TAHA-brazy/electro-hydraulic-control-system/report_ar.pdf

# التعرف التجرييب والتحكم مبخدم كهروهيدروليكي

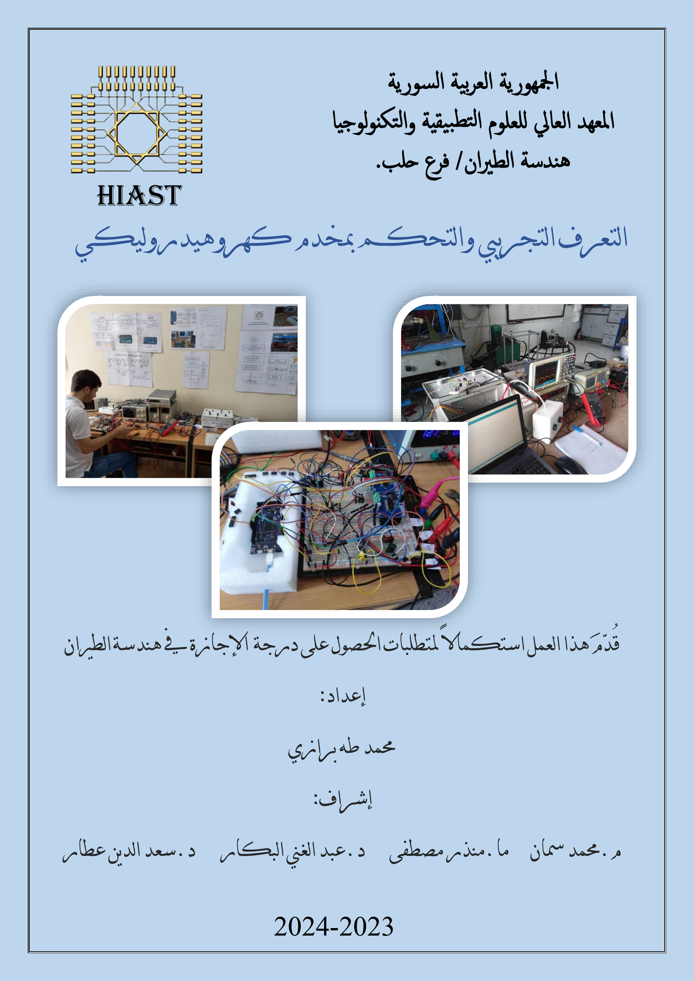
[picture p17: page 1]

### HIAST

امجلهورية العربية السوري ة املعهد العايل للعلوم التطبيقية والتكنولوجي ا هندسة الطريان / فرع حلب .

## قُدّمَ هذا العملاستكماالً ملتطلباتاحلصول على درجة اإلجازة يف هندسة الطريان إعداد: حممد طه برازي إشراف: م.حممد مسان ما.منذر مصطفى د.عبد الغين البكار د.سعد الدين عطار

2024-2023

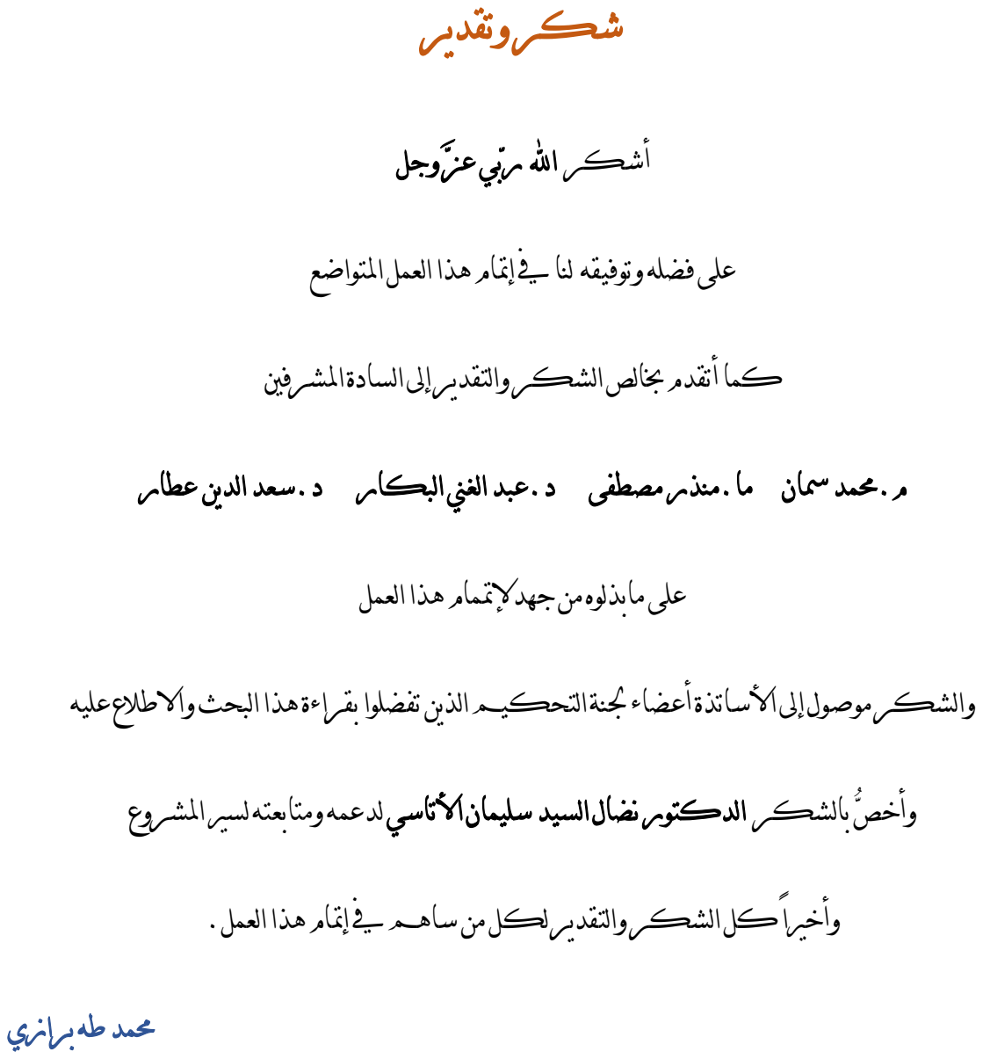
[picture p18: figure]
شكر وتقدير; أشكر اهلل ربّ ي عز وجل; على مابذلوه من جهدإلمتمام هذا العمل; حممد طه برازي

i

على فضله وتوفيقه لنا يف إمتام هذا العمل املتواضع

كما أتقدم خبالص الشكر والتقدير إىل السادة املشرفني

م.حممد مسان ما.منذر مصطفى د.عبد الغين البكار د.سعد الدين عطار

والشكر موصول إىل األساتذة أعضاء جلنة التحكيم الذين تفضلوا بقراءة هذا البحث واالطالع عليه

وأخصُّ بالشكر الدكتور نضال السيد سليمان األتاسيلدعمه ومتابعته لسري املشروع

وأخرياً كل الشكر والتقدير لكل من ساهم يف إمتام هذا العمل.

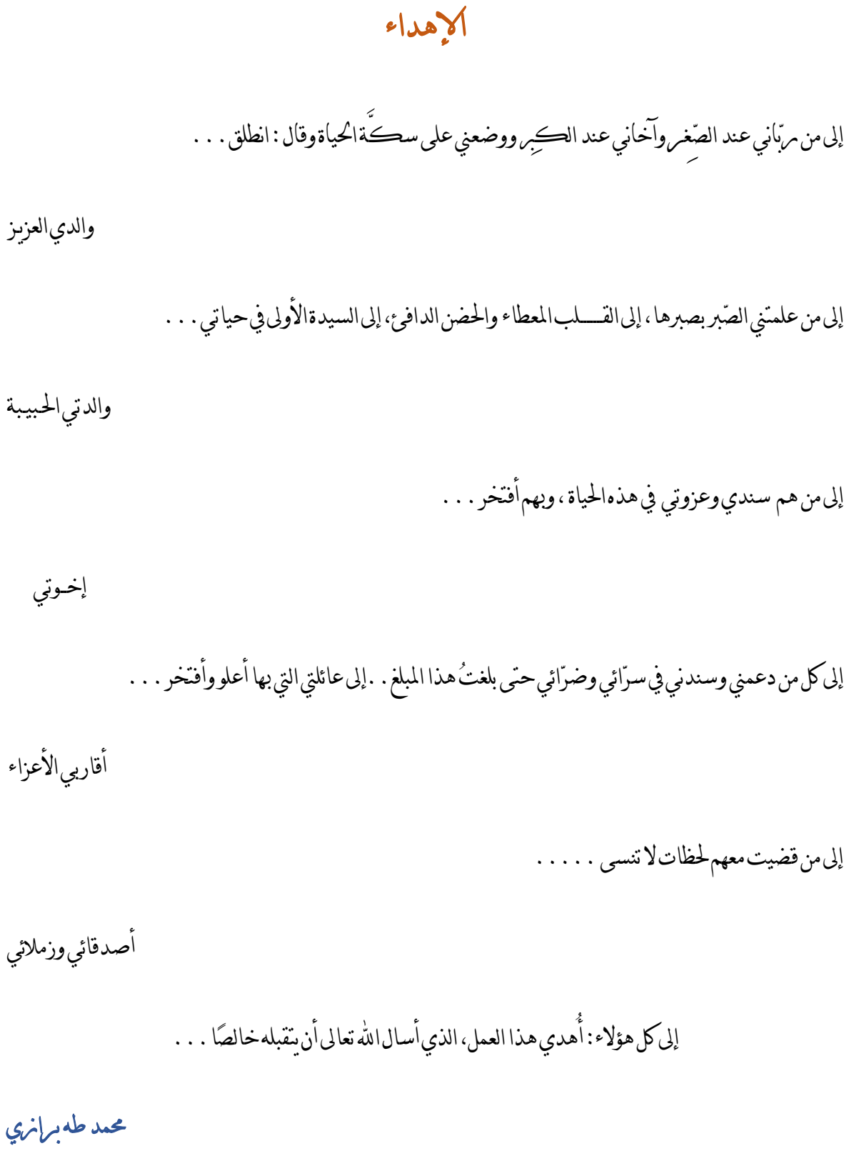
[picture p19: figure]
اإلهداء; والدي العزيـز; والدتي احلـبيـبة; إخــوتي; أقاربي األعزاء; إىل من قضيت معهم حلظات ال تنسى .....; أصدقائي وزمالئي; حممد طه برازي

ii

إىل منربّانيعند الصِّغر وآخاني عند الكِرب ووضعين على سكَّة احلياة وقال : انطلق.. .

إىل من علمتين الصّرب بصربها، إىل القـــــــلب املعطاءواحلضن الدافئ، إىل السيدة األوىل يف حياتي...

إىل من هم سندي وعزوتي يف هذه احلياة ، وهبم أفتخر...

إىل كل من دعمين وسندني يف سرّائي وضرّائي حتى بلغتُ هذا املبلغ..إىل عائليت اليت هبا أعلو وأفتخر...

إىل كل هؤالء: أُهدي هذا العمل، الذي أسال اهلل تعاىل أن يتقبله خالصًا...

iii

ملخص المشروع

يهدف هذا المشروع إلى تطوير دارة قيادة موثوقة تلبي متطلبات التشغيل والتحكم بالمنظومة الكهروهيدروليكية، وتطبيق إجرائية التعرف على النظام بهدف تحصيل نماذج معامالتية خطية والخطية ُستخدم في تصميم

ت مصحح للتحكم بالموضع مع تغذية أمامية للتغلب على العناصر الالخطية، واستخدام
ًة | تقنية التحكم التتابعي للتحكم بالتسارع كحلقة رئيسية إلى حلقة

إضاف الموضع الثانوية.

iv

Abstract

This project aims to develop a reliable driver circuit that meets the operational and control requirements of the electro-hydraulic system. It also aims to apply system identification procedures to obtain linear and nonlinear parametric models used in designing a position control corrector with feedforward to overcome nonlinear elements. Furthermore, the project uses cascade control techniques to control acceleration as the main loop, in addition to a secondary position loop.

v

فهرس المحتويات

2.1 مقدمة: 10 |
2.2 وحدة القيادة 7960BTS : 11 |
2.3 دارة المالئمة بين خرج مقسم الجهد )Potentiometer )ودخل المحول ADC : 14....
2.4 دارة مرشح تمرير منخفض تشابهي Circuit Filter Pass Low: 15 |
2.5 دارة تنظيم الجهد Circuit Voltage Regulator: 18 |
2.6 بطاقة المتحكم الصغري Due Arduino20 | :
2.7 المحول التشابهي الرقمي D/A: 21 |
2.8 مولد إشارة الـPWM: 22 |
2.9 برنامج المتحكم الصغري: 22 |
2.10 المرشح الرقمي: 23 |
الفصل الثالث: التعرف التجريبي 27 |
3.1 مقدمة 28 |
3.2 التعرف في الحلقة المغلقة: 30 |
3.3 إشارات التحفيز المستخدمة في التعرف31 | :

vi

3.4 اإلشارة الثنائية العشوائية المزيفة PRBS : 32 |
3.5 تصميم تجربة التعرف: 33 |
3.6 إجرائية تنفيذ التعرف التجريبي: 35 |
3.7 برنامج المتحكم الصغري في تجربة التعرف36 | :
3.8 تحليل النتائج ومناقشتها: 38 |
3.9 تجربة التعرف على نموذج التحكم Model Process: 39 |
3.10 تجارب التعرف على نماذج التنبؤ والنمذجة والمحاكاة: 41 |
الفصل الرابع: التحكم بالمخدم 48 |
4.1 مقدمة: 49 |
4.2 نمذجة النظام المدروس باستخدام برنامج المحاكاة Simulink\MATLAB: 49.......
50 | :Non-Linear Items | الالخطية | العناصر | 4.3
4.3.1 المنطقة الميتة (zone Dead(: 51 |
4.3.2 التأخير الزمني ) delay Time)54 | :
4.3.3 حد اإلشباع (Saturation)56 | :
4.4 التحكم بالموضع: 57 |
4.4.1 تحديد بارامترات المصحح: 57 |
ّ | 4.4.2 م الطور:

ة لمصحح مقد
ّ
المعادلة الفرقي 60 |
4.4.3 تجارب الدارة المغلقة مع مصحح مقدم الطور بعد عملية tuning: 61...
4.5 التحكم التتابعي Control Cascade: 63 |
4.5.1 التحكم التتابعي باستخدام حلقة التسارع وحلقة الموضع: 64 |
الخاتمة والتوصيات المستقبلية70 | :
المراجع العلمية 71 |

vii

فهرس األشكال

شكل -10المخطط العام لدارة القيادة 10 |
شكل -11دارة مرشح منخفض للتيار 12 |
شكل -12العالقة بين الجهد Vis وتيار الحمولة I 12 |
شكل -13تحويل االشارة النبضية إلى اشارة مستمرة 13 |
شكل -14دارة مالئمة جهد خرج ال potentiometer مع دخل المحول D/A15 |
شكل -15مرشح تمرر منخفض تشكيلة Kay Sallen من المرتبة األولى 16 |
شكل -16مرشح تمرر منخفض تشكيلة Kay Sallen من المرتبة الثانية 16 |
شكل -17مرشح تمرير منخفض نوع Butterworth تشكيلة kay sallen من المرتبة الثالثة 18 |
شكل -18مخطط بود لمرشح التمرير المنخفض من المرتبة الثالثة 18 |
شكل -20المرشح الوسطي 24 |
شكل -21 المخطط العام لدارة القيادة 24 |
شكل -22دارة القيادة أثناء االختبار 25 |
شكل -23مراحل تنفيذ عملية التعرف 29 |
شكل -24البنية األساسية لنظام في الحلقة المغلقة 30 |
شكل -25آلية إرسال واستقبال األوامر من وإلى المتحكم في تجربة التعرف 34 |
شكل -26مراحل تنفيذ التعرف التجريبي 35 |
شكل -27خوارزمية عمل المتحكم في تجربة التعرف37 |

viii

شكل -28الواجهة التخاطبية لصندوق أدوات تعريف النظام في ماتالب39 |
شكل -29بيانات دخل وخرج النظام المحصلة من أجل إشارة تحفيز نبضية 40 |
شكل -30مخطط البواقي40 |
شكل -31نسبة الباس نموذج Model Process المقدر لبيانات التحقق 41 |
شكل -32بيانات دخل وخرج النظام المحصلة من أجل إشارة تحفيز PRBS42 |
شكل -33بنية نموذج Wiener-Hammerstein الالخطي 43 |

شكل -34نسبة االلباس لنماذج Wiener-Hammerstein و Function Transfer ,Tclck =
43 | 28ms
شكل -35 نسبة االلباس لنماذج Wiener-Hammerstein و Function Transfer ,Tclck =
45 | 28ms
شكل -36تحليل البواقي لنماذج Wiener-Hammerstein و Function Transfer46 |
شكل -37 مكونات الجزء الخطي من نموذج Wiener-Hammerstein46 |
شكل -38نمذجة نموذج Wiener-Hammerstein في Simulink 47 |
شكل -39حلقة التحكم بنظام المخدم الكهروهيدروليكي 49 |
شكل -40نمذجة النظام باستخدام برامجSimulink\MATLAB 50 |
شكل -41 محاكاة استجابة النظام من أجل دخل قفزة 50 |
شكل -42تعريف المنطقة الميتة 51 |
شكل -43نمذجة المنطقة الميتة 51 |
شكل -44محاكاة استجابة النظام بوجود المنطقة الميتة 52 |
شكل -45 نمذجة حل الخطية المنطقة الميتة 52 |
شكل -46 استجابة النظام بعد إدخال حل الخطية المنطقة الميتة 53 |
شكل -47استجابة النظام الحقيقية بعد زرع حل الخطية المنطقة الميتة 53 |
شكل -48تعريف التأخير الزمني delay Time54 |
شكل -49 التأخيرالزمني من أجل دخل lov4 . = ets55 |
شكل -50نمذجة التأخير الزمني 56 |
شكل -51استجابة النظام بعد نمذجة التأخير الزمني 56 |
شكل -52المتطلبات التصميمية لنظام التحكم بالمخدم الكهروهيدروليكي 57 |
شكل -53مخطط بود للنظام قبل وبعد إضافة مصحح مقدم الطور 59 |
شكل -54مخطط مسار الجذور للنظام قبل وبعد إضاقة مصحح مقدم الطور 59 |
شكل -55االستجابة الزمنية للنظام قبل وبعد إضافة مصحح مقدم الطور 60 |

ix

شكل -56استجابة النظام الحقيقية قبل وبعد إضافة مصحح مقدم الطور 62 |
شكل -57التحكم التتابعي control Cascade63 |
شكل -58استجابة النظام في أداة engiseDmetsySlortnoc64 |
شكل -59المتطلبات التصممية للنظام في حلقتي التحكم في التسارع والموضع 65 |
شكل -60اختيار بنية حلقتي تحكم في أداة engiseDmetsySlortnoc65 |
شكل -61استجابة النظام بعد إضافة حلقتي تحكم 67 |
شكل -62معامالت مصحح حلقة التسارع 68 |
شكل -63معامالت مصحح حلقة الموضع 68 |

x

فهرس الصور

صورة 7960-5BTS11 |
صورة -6آلية التحكم جسر H14 |
صورة -7 بطاقة DUE Arduino 20 |
صورة -8الواجهة التخاطبية للقيادة والتحكم بالمخدم نمط loop Open25 |
صورة9 - الواجهة التخاطبية للقيادة والتحكم بالمخدم نمط loop Closed26 |
صورة -10صورة عن بيئة العمل وعرض بيانات الدخل والخرج أثناء التحصيل 38 |

xi

فهرس الجداول

جدول -1قيم الثوابت حسب مرشحات Butterworth17 |

جدول -2نسب التطابق لنماذج Wiener-Hammerstein وFunction Transfer من أجل 10=N و
clcT متغيرة 44 |

جدول -3 نسب التطابق لنماذج Wiener-Hammerstein وFunction Transfer من أجل 12=N و
clcT متغيرة 45 |
جدول -4قيم التأخير الزمني من جهد دخل محدد 55 |
جدول -5مقارنة بين خصائص النظام قبل وبعد إضافة مصحح مقدم الطور 62 |

املعـــهد الع ــــايل للع ـــلوم التطبيقية والتكنولوجيــــا – الســـنة اخلامسة – حمـــمد طــه بــرازي

1

مقدمة عن المشروع:

ً

أساسيا من التكنولوجيا الحديثة المستخدمة في مجموعة واسعة | ً | تعتبر األنظمة الهيدروليكية جزء
من التطبيقات. تعتمد هذه األنظمة على استخدام السوائل المضغوطة لنقل الطاقة وتحقيق الحركات الميكانيكية بدقة وكفاءة عالية. يتطلب تشغيل األنظمة الهيدروليكية بشكل صحيح وجود تحكم دقيق في الضغط والتدفق، مما يستدعي تصميم حلقات تحكم قادرة على تلبية هذه المتطلبات بكفاءة ووثوقية.
يهدف هذا المشروع إلى تصميم دارة قيادة الكترونية لمنظومة كهرو هيدروليكية، تتضمن التحكم
في صمام تخفيض الضغط وصمام التوجيه الهيدروليكي لقيادة مخدم كهروهيدروليكي متصل مع طاولة رجاجة تهتز وفق محور وحيد . باإلضافة إلى ذلك، سيتناول المشروع إجرائية التعرف على المنظومة، وذلك من أجل تطبيق تقنيات التحكم لتصميم متحكم قادر على تحسين أداء النظام. تتكون م ارحل المشروع من عدة خطوات رئيسية تشمل: د ارسة المكونات األساسية للنظام الهيدروليكي، تصميم وتنفيذ دارة القيادة، تحصيل البيانات العملية من النظام، تحليل البيانات للتعرف على النظام ا تصميم وتنفيذ واختبار متحكم مناسب ً

، وأخير .
سيسهم هذا المشروع في تقديم فهم أعمق لتطبيقات األنظمة الهيدروليكية والتحكم فيها، مع التركيز على تطوير حلول تساهم في تحسين األداء وضمان االستقرار والوثوقية. تعتبر النتائج المتوقعة من هذا المشروع خطوة مهمة نحو تعزيز المعرفة في مجال األنظمة الهيدروليكية والتحكم بها، وتقديم حلول عملية يمكن تطبيقها في الصناعة. تتكون األطروحة من أربعة فصول على الشكل التالي: .1 التعريف بالمنظومة الهيدروليكية. .2 تطوير وتنفيذ دارة القيادة. .3 التعرف التجريبي على المخدم. التحكم بالمخدم.

2

# الفصل األول: التعريف بالمنظومة الكهروهيدروليكية

3

### 1.1 مقدمة:

تعتبر المخدمات الهيدروليكية من األدوات الهامة في التطبيقات المدنية والعسكرية بسبب قدرتها العالية على توليد الطاقة و تمتعها بخصائص عديدة. انتشرت المخدمات الهيدروليكية بشكل واسع في مجموعات متنوعة من الصناعات بسبب صغر حجمها مقارنة مع الطاقة التي تقدمها، و أدائها األكثر سالسة عند السرعات المنخفضة، وقدرتها على تطبيق قوة وعزم دوران كبيرين للغاية و ال تزال هذه األنظمة مستخدمة بكثرة في التطبيقات عالية األداء مثل أنظمة التصنيع وآالت اختبار المواد ومحاكاة الطيران والسفن والروبوتات. في التطبيقات الهيدروليكية، يمكن قيادة المخدمات الكهروهيدروليكية عن طريق أوامر الكترونية تتحكم بالتدفق المطلوب، ومع ذلك فإن مشاكل النظام الهيدروليكي هي انعدام خطيتها وانخفاض التخميد ، و يصعب في بعض التطبيقات التحكم الدقيق في هذه األنظمة بسبب الالخطية، و لتحسين أداء المخدم الكهروهيدروليكي يلزم وجود متحكم مناسب .

### 1.2 المخطط الصندوقي للدارة الهيدروليكية:

شكل -1المخطط الصندوقي للدارة الكهروهيدروليكية

### 1.3 المكونات األساسية للدارة الهيدروليكية المستخدمة:

1.3.1 وحدة التغذية الهيدروليكية: تتضمن محرك كهربائي يقوم بتشغيل المضخة الهيدروليكية التي
تقوم بتحويل الطاقة الميكانيكية إلى طاقة هيدروليكية )قوة وضغط(، باإلضافة إلى صمام تنفيس الضغط الذي يقوم بتحديد الضغط األعظمي الخارج من المضخة على القيمة ab ،125 وصمام توجيه 3/4 يعمل بجهد v.24 كما تحتوي على فلتر الضغط العالي وفلتر خط العودة اللذان يقومان يتنقية السائل الهيروليكي )زيت( من الشوائب والمحافظة
وحدة التغذية الكهروهيدروليكية | وحدة التحكم الكهروهيدروليكية

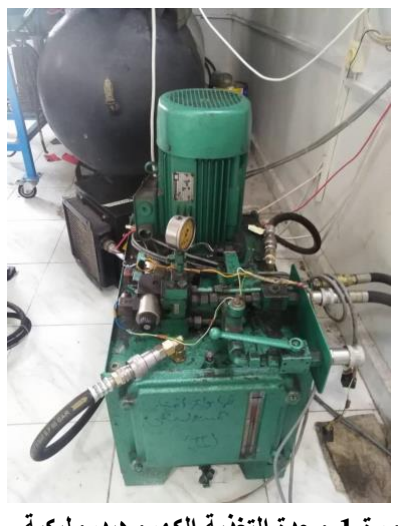
[picture p20: figure]

صورة -1وحدة التغذية الكهروهيدروليكية

4

على نظافته.
1.3.2 وحدة التحكم الكهروهيدروليكية : تتضمن وحدة التحكم الصمامين التاليين:

1.3.2.1صمام التوجيه 3/4 Valve Directional:
الغرض األساسي من هذا الصمام هو التحكم باتجاه الجريان باتجاهين متعاكسين إذ يملك ثالث وضعيات، وضعية إغالق ووضعيتين فتح تسمحان بمرور السائل باتجاهين متعاكسين، ويملك أربع مسارات : المضخة p والخزان T والمسارين A و B يتصالن بطرفي المخدم. ال يقبل الصمام تطبيق إشارة جهد متغيرة فإما أن يكون في حالة ON او في حالة OFF وفق اتجاه معين. يتكون بشكل اساسي من ملفين )وشيعتين( ملفوفين على طرفي الصمام، ومنزلقة ونابضين. حاالت عمل الصمام وفق الشكل )2(: .1 حالة عدم وجود تحريض على الملفات )الوضعية المتوسطة(: يكون الصمام في حالة إغالق)ال يوجد تدفق للسائل(.

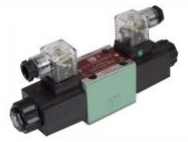
[picture p21: figure]
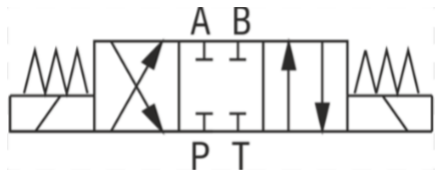
[picture p22: figure]

.2 حالة وجود تحريض على أحد الملفين: يمر تيار في الملف ً عن الملف مما يؤدي إلى

فيؤدي ذلك الى توليد قوة محركة كهربائية تدفع المنزلقة مبتعدة فتح الصمام وعبور السائل.
بتلك اآللية السابقة يتم التحكم بجهة الجريان. موديل الصمام المستخدم هو -50N24-D2-C-01-3DSG. كما توضح ال نشرة الفنية الخاصة بالصمام فإن التدفق األعظمي للصمام هو im/ 63 وضغط
2 | العمل األعظمي هو c/gK 315

، ويجب تغذيته بتغذية مستمرة ) DC )v24 ويكون تيار
الحمل األعظمي A.1.1

صورة -2صمام التوجيه

شكل -2وضعيات عمل صمام

التوجيه

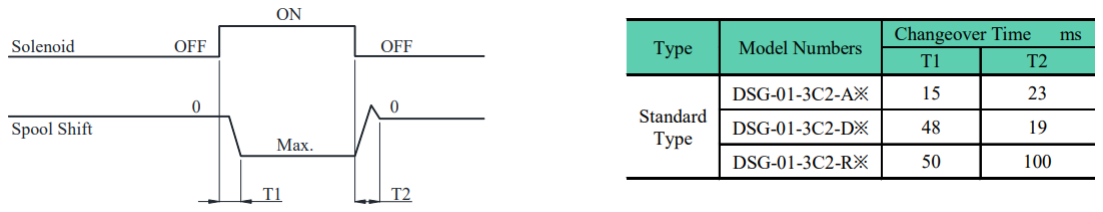
[picture p23: figure]
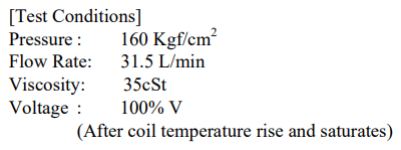
[picture p24: figure]

5

يوضح الشكل )3( شكل استجابة الصمام وأزمنة االستجابة عند شروط العمل المذكورة في الشكل : )3(

شكل -3استجابة صمام التوجيه حسب شروط عمل محددة

شكل -4شروط العمل لصمام التوجية حسب النشرة الفنية
في حالة o → fo كان زمن االستجابة للصمام m48 = 1، وفي حالة fo → o كان الزمن m19 = 2.

1.3.2.2صمام تخفيض الضغط التناسبي valve pressure reducing Proportional:
يعمل هذا الصمام الموضح بالصورة )3( على التحكم بالتدفق عن طريق تخفيض الضغط العالي القادم من المضخة. يملك الصمام وضعيتين وثالث مسارات : المضخة p والخزان T ومخرج الصمام A وتتغير وضعية الصمام بشكل تناسبي من حالة االغالق إلى حالة الفتح. يتكون بشكل رئيسي من منزلقة وملف )وشيعة( ملفوف على أحد أطرافه، باالضافة إلى نابض ارجاع في الطرف األخر. في حالة عدم تطبيق جهد كهربائي على الملف، يعيد نابض االرجاع المنزلقة إلى وضعها الطبيعي ويكون الصمام في

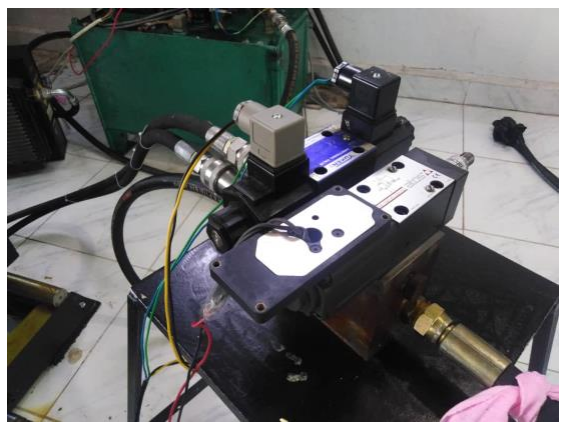
[picture p25: figure]

صورة -3صمام تخفيض الضغط التناسبي ويليه

صمام التوجيه

6

حالة إغالق. بتطبيق جهد كهربائي متغير على الملف يتم توليد قوة محركة كهربائية تدفع المنزلقة مبتعدة عن الملف، وبالتالي يزداد ضغط السائل فيزداد التدفق. تتناسب إزاحة المنزلقة مع الجهد المطبق على الملف.
موديل الصمام المستخدم هو -010/210/1PS-TERS-RZGO. كما توضح النشرة الفنية الخاصة بالصمام، فإن التدفق األعظمي للصمام im/ 12 وضغط العمل األعظمي هو /gK 210
cm²
الخصائص الكهربائية للصمام : مقاومة الملف : Ω)3.3 ~3 (من أجل جهد مستمر v.12 تيار الملف األعظمي : A2.7 من أجل جهد مستمر v.12 استطاعة الملف األعظمية : Watt.40
وفقا ، من أجل سائل هو زيت من نوع ISO | ً للنشرة الفنية
0 | 46 VG وبدرجة حرارة 50

تم اختبار الصمام ونتج عنه
المخطط )الشكل )6(( الذي يوضح العالقة بين االشارة المرجعية المطبقة)كنسبة مئوية من القيمة العظمى v12 ) والضغط عند مخرج الصمام. نالحظ أن العالقة

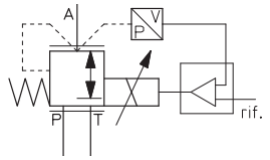
[picture p26: figure]
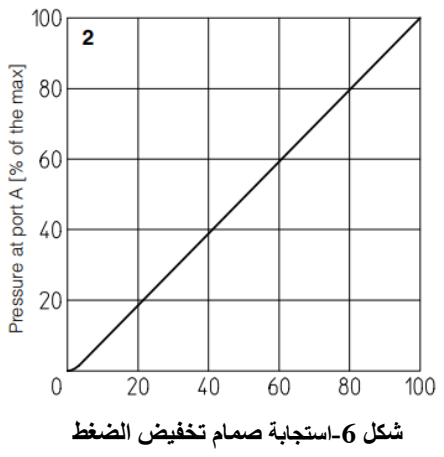
[picture p27: figure]
شكل -6استجابة صمام تخفيض الضغط

خطية مع وجود تأخير زمني بسيط. عند تطبيق إشارة مرجعية على شكل قفزة، وجد أن زمن االستجابة كان m .40

### 1.4 المخدم Actuator:

يقوم المخدم بتحول الطاقة الهيدروليكية القادمة من المضخة إلى طاقة ميكانيكية تقوم بتحريك الطاولة بحركة خطية باتجاهين متعاكسين. المخدم المستخدم هو عبارة عن اسطوانة ومكبس. يوجد عدة أشكال لالسطوانات )الشكل)7(( الطاقة التي يمكن استخدامها حسب التطبيق المطلوب واالسطوانة المستخدمة هي اسطوانة ثنائية

شكل -5مخطط صمام تخفيض

الضغط

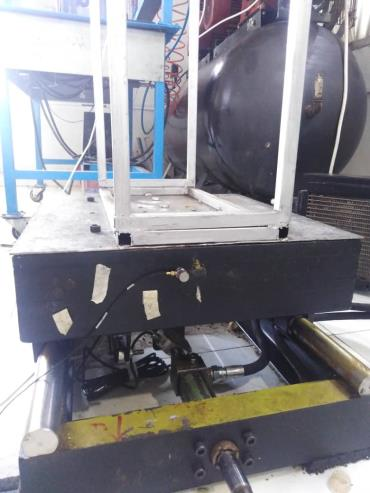
[picture p28: figure]

صورة -4المخدم مع الطاولة

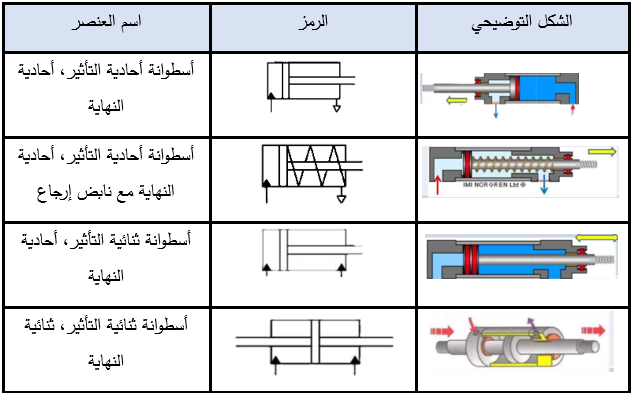
[picture p29: figure]

7

التأثير وثنائية النهاية، يمكن فيها أن يتعرض كال سطحي المكبس للضغظ العالي وبالتالي يمكن تحريك الحمل في اتجاهين متعاكسين. إن طول شوط المكبس المستخدم هو m47.

شكل -7انواع اسطوانات الطافة
يتوضع المخدم أسفل الطاولة ويتصل بها بواسطة ذراع، كما يتصل مع المخدم حساس إزاحة )مقسم جهد ( Potentiometer والذي هو عبارة عن مقاومة متغيرة تعمل عمل مقسم الجهد الشكل )8(، تتصل مع ذراع المخدم وتقوم بتحديد موضع الطاولة الحالي من خالل قياس فرق الجهد بين نقطة الوقوف الحالية واألرضي ويتم تحويل قيمة الجهد المقاسة إلى مسافة من خالل ضربها بمقلوب ربح مقسم الجهد. يتم تحديد ربح المقسم من خالل معرفة طول المنزلقة والتغذية المطبقة، طول المنزلقة للمقسم المستخدم هو mm300 ويقبل تغذية مستمرة حتى v.28 تم تغذية
1 | مقسم الجهد المستخدم ب v10 وبالتالي يكون ربحه
30

volt
mm

. تم تحديد

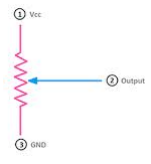
[picture p30: figure]

مجال عمل المخدم من خالل قياس خرج مقسم الجهد عند كل من بداية الشوط ونهاية الشوط فوجد

.[1.05 3.56]v

شكل -8مقسم الجهد
potentiometer

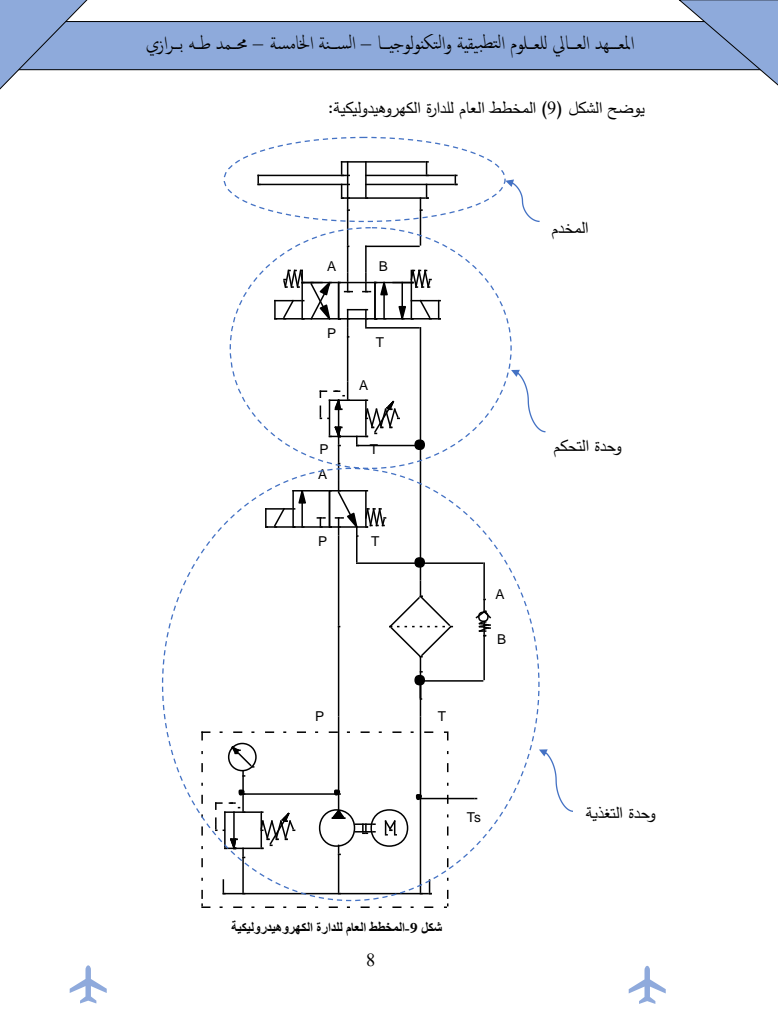
[picture p31: page 20]
المخدم; وحدة التحكم; وحدة التغذية

يوضح الشكل )9( المخطط العام للدارة الكهروهيدوليكية:

شكل -9المخطط العام للدارة الكهروهيدروليكية

9

# الفصل الثاني: تطوير وتنفيذ دارة القيادة

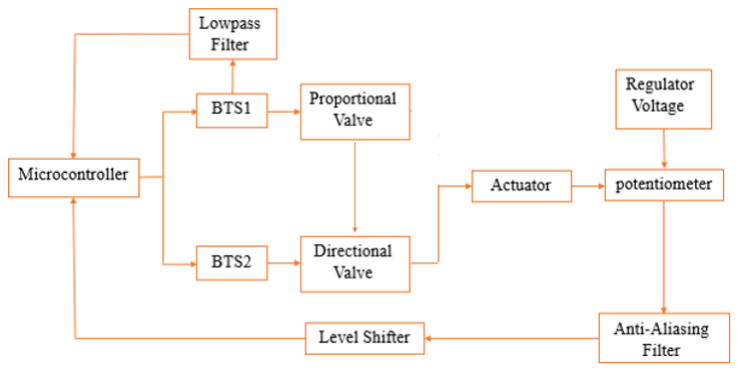
[picture p32: figure]

10

### 2.1 مقدمة:

تم تطو ير دارة قيادة موثوقة للمخدم الكهروهيدروليكي تقوم بتأمين كافة متطلبات التشغيل والتحكم بصمام تخفيض الضغط وصمام التوجيه اللذان هما عنصرا التحكم في المنظمومة الهيدروليكية. تتكون الدارة من وحدتي قيادة 7960 BTS بشكل رئيسي واللتان تقومان بتأمين االستطاعة الالزمة لعمل الصمامين السابقين باإلضافة إلى دارات إضافية ملحقة مثل دارة مالئمة ودارات ترشيح ودارة تنظيم الجهد. يوضح المخطط الصندوقي التالي الشكل العام لدارة القيادة:

شكل -10المخطط العام لدارة القيادة

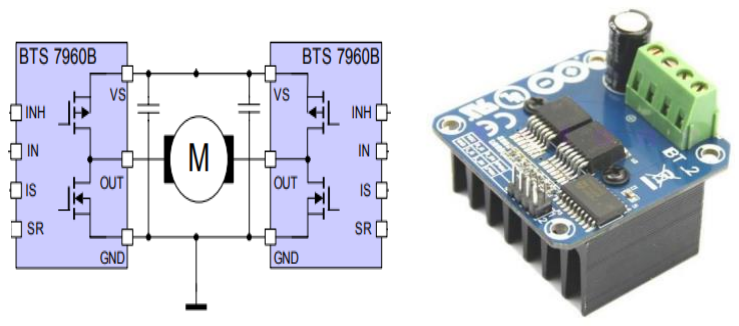
[picture p33: figure]

11

### 2.2 وحدة القيادة 7960BTS :

تم استخدام وحدتي قيادة 7960BTS المبينة بال صورة )5( من أجل قيادة كل من صمام
ًة تم استخدام

التدفق وصمام التوجيه من خالل تأمين االستطاعة الالزمة لعمل الصمامين. بداي وحدة التحكم 298LM ولكن بسبب عدم تحملها لتيار الحمل )A3 )وعدم امتالكها لمبرد كافي، تم اللجوء إلى الوحدة 7960BTS التي تتحمل تيار يصل ل A43 مع امتالكها لمبرد كافي، وكما أنها تستخدم ترانزستورات Mosfet التي تتمتع بكفاءة عالية مقارنة مع الترانزستورات الثنائية التي تستخدمها الوحدة 298LM، لذلك تعتبر الوحدة 7960BTS أنسب للمشروع المطروح.

صورة 7960-5BTS
مميزات الوحدة 7960BTS الموضحة في النشرة الفنية : .1 جهد التغذية : v27~.6
.2 تيار الحمولة األعظمي: A.43 .3 جهد التحكم: v5~.3.3
.4 اشارة التحكم: مستوى )Level )او بتعديل عرض النبضة (PWM (بتردد يصل حتى

.25kHz
.5 تؤمن الحماية من تيار قصر جهد األرضي، الحماية من تيار قصر جهد التغذية، الحماية من تيار قصر الحمولة.
.6 الحماية من ارتفاع الحرارة فأي ارتفاع في الحرارة يتم اغالق مرحلة الخرج لحين تصفير الحالة.

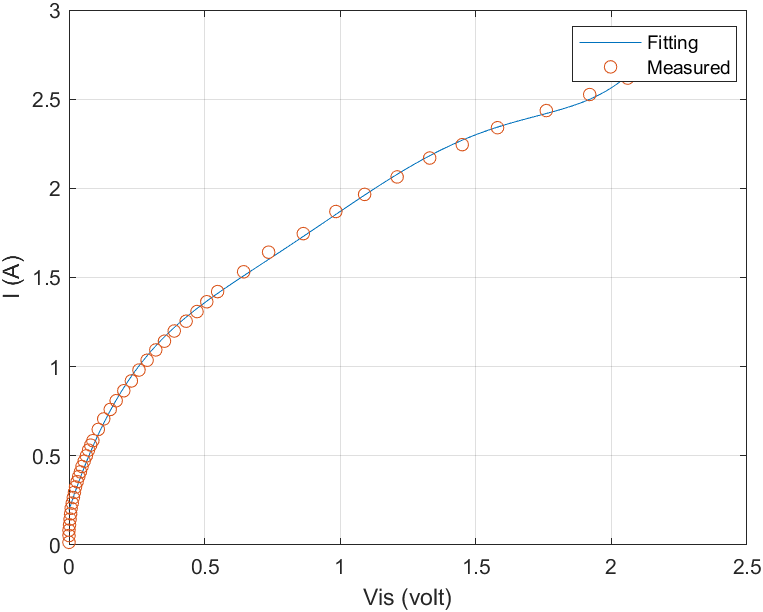
[picture p34: figure]

12

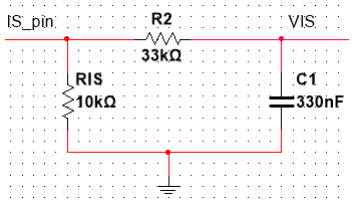
[picture p35: figure]

أهم ميزة للدراة 7960BTS أنها تتيح إمكانية تحسس تيار الحمل.
سيتم قياس تيار الحمولة لصمام التوجيه من النقطة IS وفق الدارة المبينة في الشكل)11(:
Ωk10 IS = تم الحصول على أكبر | من أجل المقاومة
lov2.25 = I وهي مناسبة كقيمة دخل | قيمة جهد
.A/D | للمحول
وتيار الحمل وذلك من خالل أخذ عدة | I | من أجل قياس التيار، تم تحديد العالقة بين الجهد
قراءات للجهد والتيار حيث تم وضع مقياس تيار على التسلسل مع الحمل من أجل أخذ قراءة التيار وتم أخذ قراءة الجهد IV من خالل وصل المخرج IS إلى راسم االشارة. تم أخذ عدة قراءات بخطوة مناسبة وتم مسح كامل مجال التغذية لصمام تخفيض الضغط التناسبي v]12~0 [وتسجيل
والتيار . ثم تم رسم النقاط وتم الباسها بأفضل منحني على الشكل | I | قراءات كال من الجهد
التالي:

شكل -12العالقة بين الجهد Vis وتيار الحمولة I

شكل -11دارة مرشح منخفض للتيار

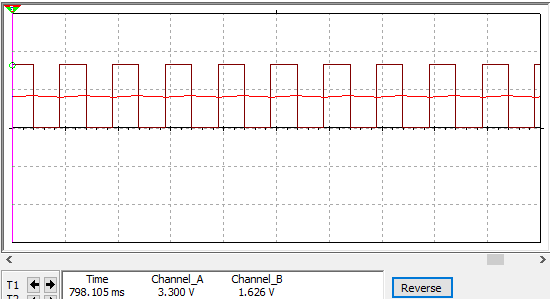
[picture p36: figure]

13

وتم استنتاج عالقة منحني االلباس وزرعها في المتحكم من أجل حساب قيمة التيار المقابلة لقيمة
المقاسة وكانت العالقة من الشكل : | I | الجهد

I = 0.6677VIS

5 − 3.775VIS

4 + 7.911VIS

3 − 7.814VIS

2 + 4.685VIS + 0.198
كما تمت إضافة دارة مرشح تمرير منخفض كما في الشكل)11( مكون من المقاومة 2 و المكثف 1 من أجل تحويل إشارة التحكم النبضية )PWM )إلى إشارة مستمرة. تم اختيار قيم المقاومة
1 | والمكثف للحصول على تردد قطع =
2πRC

H15 = وهو بعيد بشكل كافي عن تردد حزمة
النظام H.7

شكل -13تحويل االشارة النبضية إلى اشارة مستمرة
يوضح الشكل )13( أعاله كيف يقوم المرشح بتحويل إشارة التحكم النبضية إلى إشارة مستمرة متوسطة القيمة بالنسبة إلشارة التحكم. توضح الصورة ) 6( آلية التحكم المعتمدة للتحكم في صمام تخفيض الضغط وصمام التوجيه. حيث انه في صمام التوجيه يتم استخدام كال فرعي الجسر H من أجل التحكم بجهة جريان السائل في الدارة الكهروهيدروليكية وكل فرع يكون مسؤول عن اتجاه معين إما Forward او Backward. أما في صمام تخفيض الضغط التناسبي فيتم فيه استخدام فرع واحد فقط من الجسر من أجل التحكم في قيمة الضغط على مخرج الصمام من خالل التحكم في إزاحة المنزلقة وال حاجة

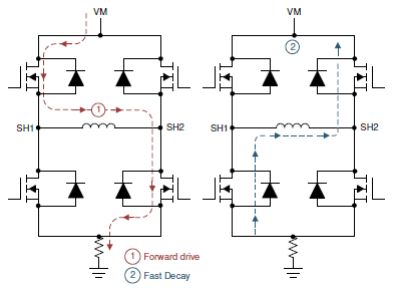
[picture p37: figure]

14

الستخدام الفرع االخر إلغالق الصمام بسبب وجود نابض إرجاع موجود في بنية الصمام كما تم شرحه سابقاً.

صورة -6آلية التحكم جسر H

### 2.3 دارة المالئمة بين خرج مقسم الجهد )Potentiometer )ودخل المحول ADC :

يقتصر عمل الدارة على تخفيض مستوى خرج من v]3.56 ~1.05 [إلى المستوى v]3.3 ~0 [ ليتالئم مع دخل Due Arduino الذي ال يمكن أن يستقبل او يرسل قيمة اكبر من v.3.3 يوضح الشكل )14( نمذجة الدارة باستخدام برنامج Multisim.

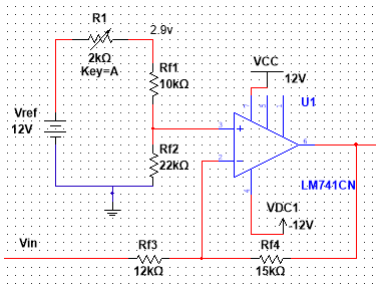
[picture p38: figure]

15

شكل -14دارة مالئمة جهد خرج ال potentiometer مع دخل المحول D/A
يكون خرج الدارة السابقة مقلوب أي من أجل دخل v]3.56 1.05 [يكون الخرج v]0 3.3[، تم أخذ هذا القلب بعين االعتبار في البرنامج.

### 2.4 دارة مرشح تمرير منخفض تشابهي Circuit Filter Pass Low:

تم اختيار المرشح من نوع Butterworth ويتشكيلة Kay Sallen النه يتميز بحزمة تمرير وحزمة منع مسطحة بحيث يحافظ على الربح )ربح المرشح واحدي(، وكذلك األمر في حزمة المنع مما يجعل حزمة العبور عريضة. من أجل الحصول على حزمة عبور ضيقة تم اختيار مرتبة المرشح من المرتبة الثالثة. يقوم المرشح التشابهي بإزالة ضجيج التردد العالي المتراكب على اإلشارة التشابهية قبل أن تصل إلى المحول D/A. يشمل هذا قمم الضجيج الخارجي، بينما ال يمكن للمرشح الرقمي القضاء على هذه القمم التي تتراكب على االشارة التشابهة. يعمل المرشح على إزالة ضجيج الترددات األعلى من تردد نيكويست أو يقللها بشكل كبير. من المشروع السابق [1] تم اقتباس عرض حزمة النظام H7 = B وعليه يمكن استرجاع
H 500 = بما | اإلشارة عمليا Hz7 . لذا تم افتراض | ً إذا كان تردد التعيين أكبر بكثير من
المتحكم الرقمي الذي سيستخدم يتيح هذه السرعة، ولتحقيق شرط نيكويست يجب أن يكون تردد
≥ | قطع المرشح
1
2
H 100 = وهو مناسب لحالة النظام المدروس. | . إذن تم اختيار | f

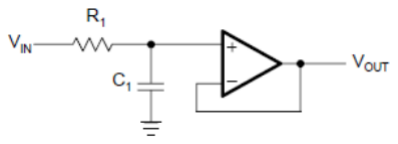
[picture p39: figure]
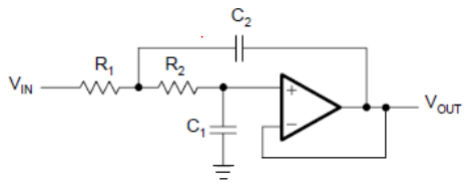
[picture p40: figure]

16

سيتم حساب بارامترات المرشح على مرحلتين : .1 مرشح مرتبة أولى:
يبين الشكل )15( شكل مرشح المرحلة األولى :

شكل -15مرشح تمرر منخفض تشكيلة Kay Sallen من المرتبة األولى
يتم حساب معامالت المرشح من العالقة التالية:

R1 =

a0
2πfcC1
حيث تم اختيار قيمة المكثفة n001 = C حسب القيم المتوفرة و تم الحصول على قيمة 1 = 0 من الجدول)1( الذي يعطي قيم هذه الثوابت حسب مرشحات Butterworth. وعليه تكون قيمة المقاومة:

R1 = 15. 9 KΩ
.2 مرشح مرتبة ثانية:
يبين الشكل )16( شكل مرشح المرحلة الثانية:

شكل -16مرشح تمرر منخفض تشكيلة Kay Sallen من المرتبة الثانية
يتم حساب معامالت المرشح من العالقات التالية:

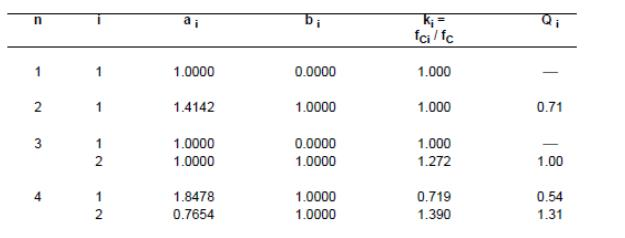
[picture p41: figure]

17

R1,2 =

a1C2 ∓ √a1
2C2

2 − 4b1C1C2
4πfcC1C2

C2 ≥ C1

4b2
a2

2
تم اختيار قيمة المكثفة n47 = 1 ، وقيم الثوابت 1 = 2 , 1 = 2 من الجدول )1(. وعليه يمكن حساب قيم المكثف 2 والمقاومات 1,2:

→ C2 ≥ 188nF
تم اختيار n033 = C حسب القيم المتوفرة.

→ R1 = 5824.8 Ω , R2 = 28037 Ω
تم تقريب قيم المقاومات لقيم متوفرة على الشكل :

→ R1 = 5. 6KΩ ,R2 = 27KΩ
تم حساب االنزياح في تردد قطع المرشح الناتج عن تعديل قيم المقاومات فكان على الشكل:

∆fc = 3Hz

جدول -1قيم الثوابت حسب مرشحات Butterworth
تم نمذجة دارة المرشح السابقة باستخدام Multisim كما يوضح الشكل )17(:

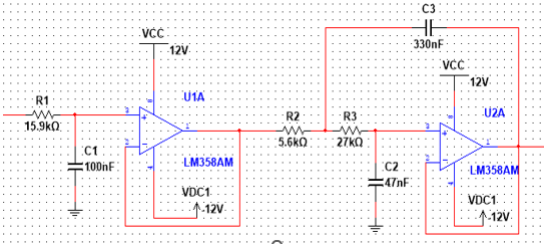
[picture p42: figure]
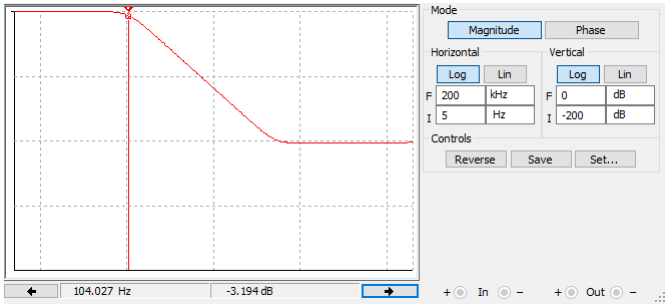
[picture p43: figure]

18

شكل -17مرشح تمرير منخفض نوع Butterworth تشكيلة kay sallen من المرتبة الثالثة
H103 ≈ والموافق | يبين الشكل )18( مخطط بود للمرشح والذي يوضح تردد قطع المرشح
ً | لربح d−3 تفسير االنزياح في قيمة تردد القطع والناتج عن تغيير في قيم المقاومات

. تم سابقا
بما يتالءم مع القيم المتوفرة.

شكل -18مخطط بود لمرشح التمرير المنخفض من المرتبة الثالثة

### 2.5 دارة تنظيم الجهد Circuit Voltage Regulator:

الهدف من الدارة هو تأمين جهد v10 منظم ودقيق من أجل تغذية عنصر التغذية العكسية وهو ال potentiometer الذي هو عبارة عن مقاومة متغيرة تعمل عمل مقسم الجهد. تم استخدام الشريحة 317LM من أجل تحقيق ذلك وفق الدارة التالية:

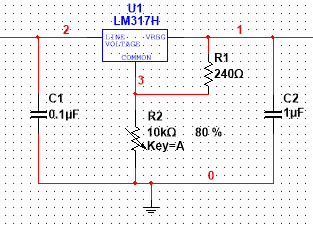
[picture p44: figure]

19

شكل -19دارة منظم جهد v10
تم تغذية الدارة السابقة بجهد v12 وضبط قيمة المقاومة المتغيرة للحصول على قيمة جهد الخرج المطلوبة v10 لتغذية ال potentiometer.

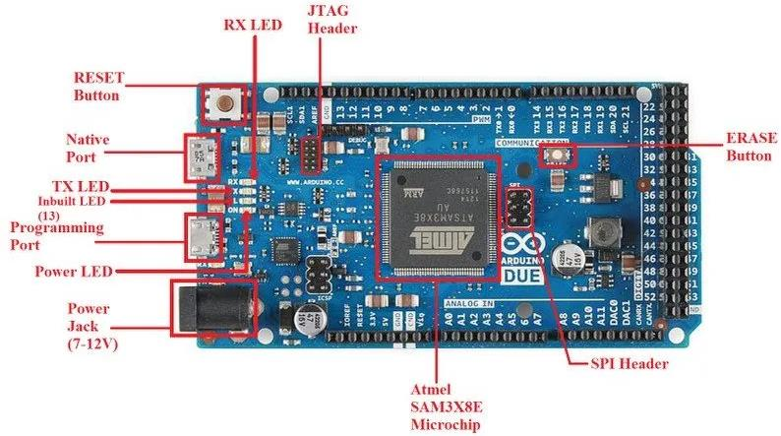
[picture p45: figure]

20

### 2.6 بطاقة المتحكم الصغري Due Arduino:

Due Arduino هو لوحة تطوير، كما توضح الصورة )7( ، تحتوي على معالج ARM 3M-Cortex بسرعة MHz.84 تحتوي اللوحة على 54 دبوس إدخال/إخراج رقمي، 12 منها يمكن استخدامها كمخارج PWM، 12 مدخل تشابهي، 4 منافذ اتصال تسلسلي و مخرجين DAC. . ويجب التحذير من أن الجهد األعظمي المسموح للمداخل والخارج هو V.3.3

صورة -7 بطاقة DUE Arduino
ما يميز أداء بطاقة المتحكم أردينو ديو [2] أنها تعتمد معالج نوع ARM] 3 [يملك المواصفات التالية:
✓ نواة بـbit32 تسمح بعمليات على بيانات بعرض 4 بايت في دور ساعة وحيد للـCPU
✓ تردد ساعة الـCPU MHz.84

.96 Kbytes RAM ذاكرة✓
✓ ذاكرة الكود kBytes.512
✓ DMA تريح الـCPU من مهام ذاكرة ضخمة. ✓ باإلضافة إلى منفذين للـ (bit12(DAC.

21

المواصفات التقنية للبطاقة: ✓ جهد الدخل 12~7
✓ الجال األعظمي لتغير الجهد: V16~6 ✓ جهد التشغيل النظامي V3.3 ✓ التيار المستمر اإلجمالي على خطوط O/I هو mA .130 ✓ التيار المستمر األعظمي للمخرج V3.3 هو mA .800 ً

✓ الثنائي الضوئي المدمج مربوط مع المخرج 13 وهو منفذ PWM ايضا ✓ كل منفذ O/I يمكن أن يقدم تيار من mA 3 / mA 15 ويستهلك تيار من mA 6 / 9 mA ويمتلك مقاومة للتغذية k .100

### 2.7 المحول التشابهي الرقمي D/A:

يأتي هذا المحول ضمن بطاقة المتحكم بدقة تصل حتى (bits12 (كما هو وارد في نشرة المواصفات الفنية لبطاقة األردينو ديو. إن دقة المحول D/A يجب أن تكون أكبر بكثير من دقة ً تحديد حساسية ال potentiometer وهي:

حساس التغذية العكسية )potentiometer). تم سابقا

(3.65 − 1.05)[V]
(74 − 0)[mm]

= 34[mV/mm]
لذلك تكون دقة المحول D/A المطلوبة من رتبة 5 إلى 10 أمثال هذه الدقة أي mv3.4 − .6.8 يوافق هذا على األقل الدقة

ADC − resolution =

3300[mV]
3.4[mV]

= 970
وهي تقابل دقة bits10 ولكن تم اعتماد الدقة bits.12 من جهة ثانية فإنه ال فائدة لهذه الدقة إذا كان مستوى ضجيج حساس التغذية العكسية أكبر من دقة المحول D/A. تم مراعاة هذا األمر عند تصميم مرشح التغذية العكسية حيث تم أخذ دقة المحول بعين االعتبار عند تحدد رتبة المرشح بحيث يكون مطال اإلشارة المرشحة في حزمة المنع أقل من دقة المحول D/A.

22

### 2.8 مولد إشارة الـPWM:

ً ضمن بنية المتحكم وهو متغير الدقة ويتبع تردد ضبط

ً ايضا

يأتي مولد النبضات المعدل عرضيا مولد النبضات. لذلك البد من تحديد دقة الـPWM المناسبة. إن شرط تحديد دقة الـ PWM يجب أن يكون أكبر أو يساوي دقة الـD/A أي أكبر أو يساوي
.10bit
من جهة أخرى يجب تحديد تردد الـPWM على أن يكون أكبر بكثير من عرض حزمة النظام المتحكم به.
من جهة ثانية يجب م ارعاة أن زيادة التردد يضاعف من األثر الح ارري المتولد في ملف الصمام لذلك البد من التوازن بين تخفيض التأثير الح ارري وتحقيق سرعة االستجابة. ولمراعاة الدقة والتردد فقد تم اعتماد دقة الـPWM هي bits12 و بتردد kHz،1 إذ لوحظ أثناء العمل أنه عند استخدام ترددات أعلى من kHz1 يبدء أداء ملف الصمام بالتراجع، إذ تزداد العتبة الدنيا لحركة المنزلقة بسبب الضياعات في الطاقة بفعل األثر الح ارري المتولد في الملف.

### 2.9 برنامج المتحكم الصغر ي:

كما أسلفنا فإن مهمة المتحكم الصغري في بطاقة األردينو UD هي توليد إشار ات التحكم الالزمة لدارة القيادة سواء في نمط التحكم أو نمط التعرف، كما يقوم تحصيل كال من بيانات الموضع
والتيار المفلترة تشابهيا . يتم بعدها تطبيق المرشح الرقمي على هذه | ً من حساسات التغذية العكسية
البيانات للتخلص من الضجيج المتراكب على االشارات وزيادة درجة الترشيح ضمن حزمة استجابة النظام.
تم ت حديد تردد التقطيع المناسب لتحصيل بيانات إشار ات الخرج باالعتماد على المعرفة المسبقة في نظام المخدم الكهروهيدروليكي والذي يملك عرض حزمة H7 = B، بالتالي تم اختيار تردد
H500 = والذي يقابل دور هو | التقطيع بحيث يكون أكبر بكثير من عرض حزمة النظام
m2 = T. لذلك فقد تم تصميم مقاطعة مؤقت تحدث كل m.2 يتم فيها تحصيل حالة مرشحة لبيانات الموضع والتيار وضبط مؤقت القاعدة الزمنية المستخدم لمراقبة إشارات األمر و حالة عمل البرنامج.

23

ولكي ال تحدث عملية تصادم بين إجرائية الكتابة في الموقع الذاكري المخصص لبيانات الموضع
ُ | والتيار و إجرائية القراءة منها، يتم نسخ عينة إضافية من البيانات في الوقت ال ذي

تحجب فيه
مقاطعة المؤقت ما يمنع حدوث ظاهرة الدخول اآلني إلجرائيتين في الذاكرة. ويتألف البرنامج ككل من البرمجيات التالية: 1( برمجيات تهيئة المؤقتات لتأمين قاعدة زمنية مضبوطة وتهيئة مولد إشارات الـPWM وتهيئة المداخل والمخارج الرقمية وتهيئة المحول ADC ومنافذ الـPWM. 2( برمجية مراقبة إشارات األوامر واالستجابة للموضع. 3( برمجية مراقبة دورة عمل المتحكم. 4( برمجية مقاطعة المؤقت.

### 2.10 المرشح الرقمي:

يستخدم المرشح الرقمي تقنيات الـsampling-over والوسطي لتقليل الضجيج ضمن مجال حزمة ا ألن الترشيح الرقمي يحدث بعد عملية التحويل ً

النظام. نظر D/A، فيمكن إزالة الضجيج المتولد أثناء عملية التحويل )مثل ضجيج التكميم( والذي ال يمكن ترشيحه باستخدام المحول التشابهي. من السهولة برمجة المرشح الرقمي مما يسمح ببرمجة تردد قطع المرشح. إن زيادة تردد التقطيع يزيد من خطأ التكميم والذي بدوره يتطلب مرشح رقمي بتردد وطول أكبر من جهة أخرى والذي عادة ما يكون تردده أكبر بكثير من تردد التقطيع. تعطى معادلة المرشح الفرقية بالشكل:

y(n) =

1
M + 1∑x(n − k)

M

k=0
تم تنفيذ هذا المرشح الوسطي باعتبار أربع عينات وثالث مراحل تأخير كما يظهر في الشكل .)20(

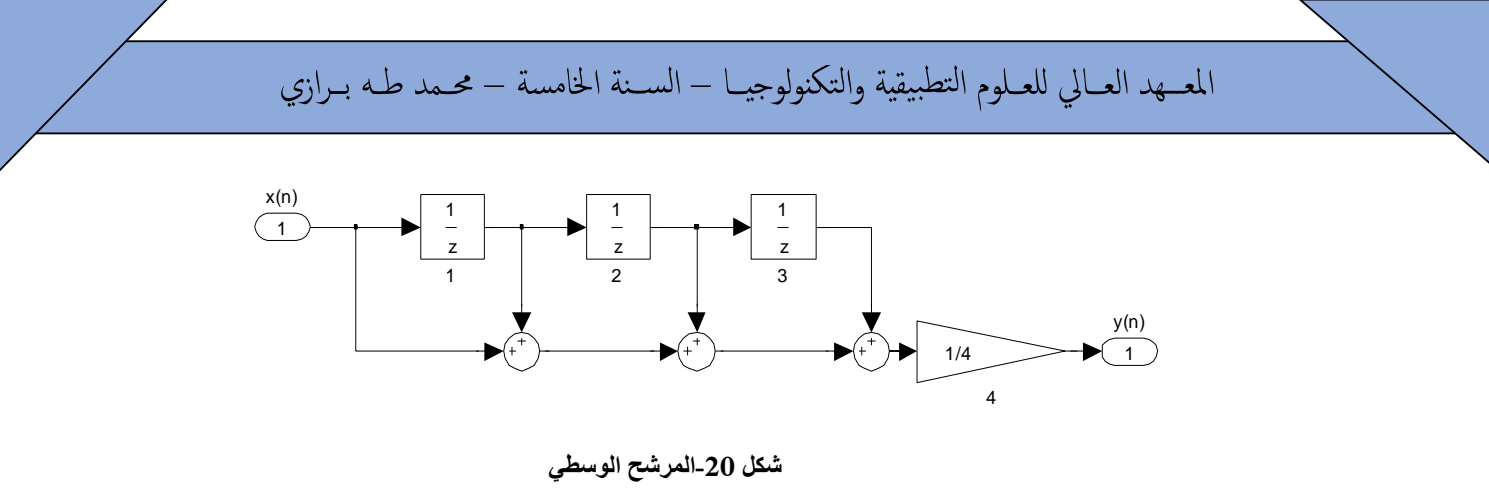
[picture p46: figure]
شكل -20المرشح الوسطي
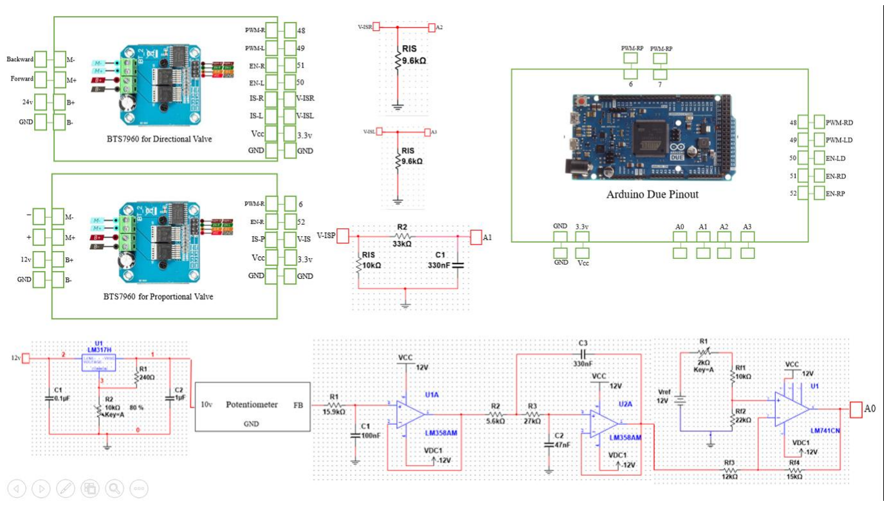
[picture p47: figure]

24

يوضح الشكل )21( المخطط العام لدارة القيادة :

شكل -21 المخطط العام لدارة القيادة

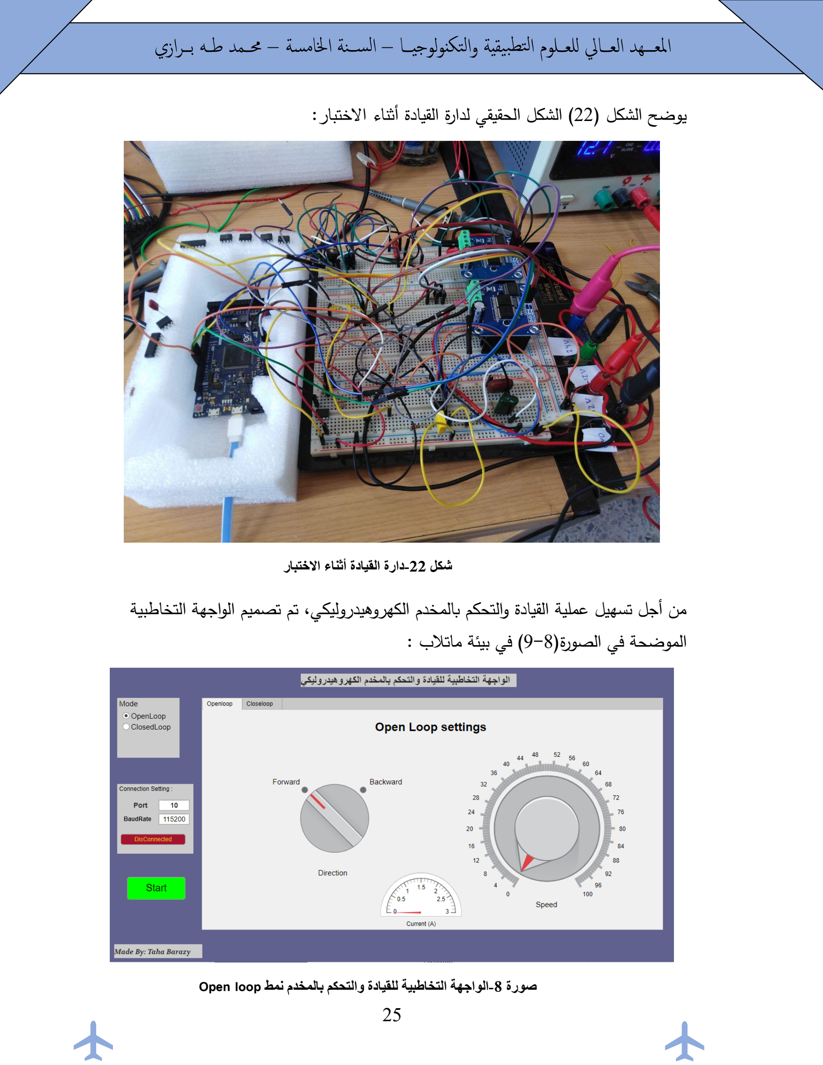
[picture p48: page 37]

25

يوضح الشكل )22( الشكل الحقيقي لدارة القيادة أثناء االختبار:

شكل -22دارة القيادة أثناء االختبار
من أجل تسهيل عملية القيادة والتحكم بالمخدم الكهروهيدروليكي، تم تصميم الواجهة التخاطبية الموضحة في الصورة) 9-8( في بيئة ماتالب :

صورة -8الواجهة التخاطبية للقيادة والتحكم بالمخدم نمط loop Open

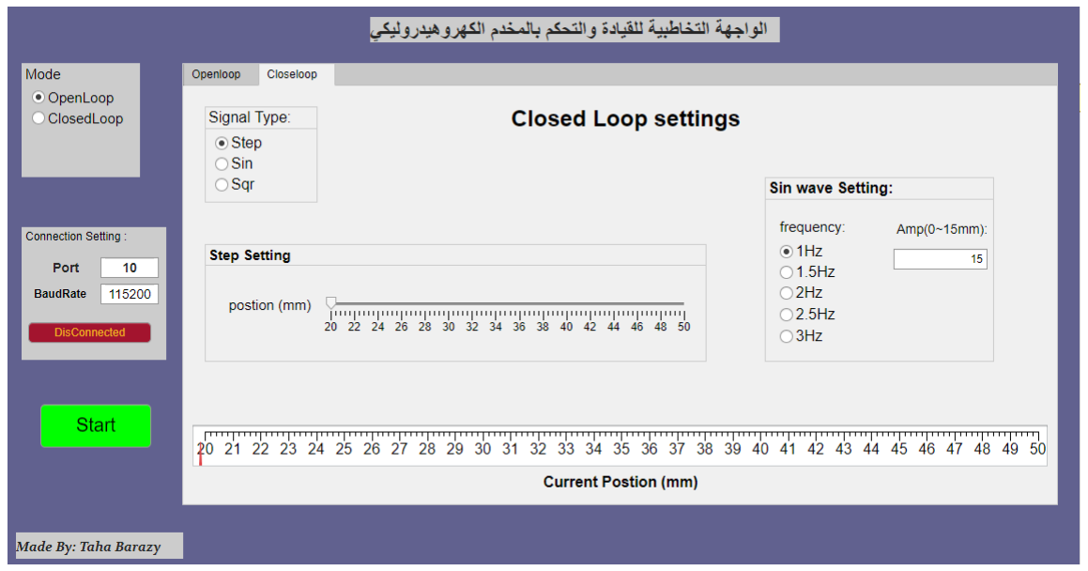
[picture p49: figure]

26

صورة9 - الواجهة التخاطبية للقيادة والتحكم بالمخدم نمط loop Closed
يتم في نمط الدارة المفتوحة )loop Open )قيادة المخدم من خالل تحديد جهة وسرعة الحركة حيث تقابل قيمة السرعة قيمة جهد الدخل المطبق )v12 من أجل سرعة %100(، ويمكن في هذا النمط مالحظة قيمة المنطقة الميتة (zone Dead (حيث ال تتحرك الطاولة عند تطبيق إشارة سرعة أقل من %12 )v1.44). كما يمكن مرقبة تيار الحمولة بشكل مستمر من القائس

.Current
أما في نمط الدارة المغلقة )loop Closed)، يتم فيها التحكم في المخدم من خالل اختيار نوع إشارة الدخل )sqr-sin-step). في حالة اختيار إشارة دخل قفزة Step يجب تحديد مطال اإلشارة أو الموقع المطلوب من خالل setting Step. من أجل تطبيق قطار من النبضات يمكن اختيار نوع اإلشارة sqr. أما في حالة تطبيق إشارة جيبية Sin يمكن فيها تحديد التردد ومطال اإلشارة

.sin wave setting من( 0~15mm(
تم تحديد مجال عمل المخدم هو من mm20 إلى mm50 حيث وجد أنه أفضل مجال خطي لعمل المخدم. يمكن مراقبة موقع الطاولة الحالي من القائس position Current. كذلك يجب التأكد من تهيئة إعدادات االتصال مع المتحكم من setting Connection قبل إجراء أي تجربة.

27

# الفصل الثالث: التعرف التجريبي

28

### 3.1 مقدمة

يهدف التعرف إلى بناء نماذج رياضية من أصل بيانات دخل وخرج. وهي مسألة فرعية مهمة في علم اإلحصاء، كذلك العديد من طرق التعرف و أدوات التحليل تكون خصائصها لها أصل في اإلحصاء. بدأ تطور تعريف النظام في الستينيات ] 4[. كانت القوة الدافعة المهمة لهذا التطور هي االهتمام المتزايد بالتحكم المعتمد عل إيجاد النموذج و الذي حفزه عمل كالمن في مجال التحكم األمثلي. منذ ذلك الحين، شهد مجال تعريف ا وهو اليوم مجال بحث ارسخ. ً

ا سريع
ً

النظام نمو
من وجهة نظر هندسة التحكم والنظم يستخدم التعرف ألهداف متعددة نذكر منها: ✓ في النمذجة والمحاكاة، ألن النموذج الناتج يمكنه محاكاة سلوك ال يستطيع التقاطه نموذج المبدأ األول.
✓ في تصميم المصححات ما يسمح بتصميم المتحكم األكثر مالئمة لسلوك النظام في الحلقة المغلقة.
✓ في التنبؤ في خطوة واحدة لألمام أو بعدة خطوات تمثل أفق معين في المستقبل القريب . ✓ في كشف أخطاء النظام عن طريق رصد البواقي أو خطأ المتنبئ. يمكن تقسيم مسألة التعرف إلى عدد من المراحل التكرارية : .1 تصميم تجربة التعرف، وهو المحتوى األهم لتجربة التعرف. وإن أحد أهم عوامل نجاح التجربة أن تنفذ التجربة في ظروف أقرب ما يكون فيها من النظام.
.2 جمع البيانات ، ويجب أن تحمل البيانات المحصلة على أكبر كم ممكن من البيانات المعلوماتية.
.3 اختيار بنية النموذج، وهي المرحلة األصعب على اإلطالق. يجب أن تعتمد على المعلومات المسبقة عن النظام وخصائصه. ويمكن أن ينظر في استخدام هذا النموذج إذا لم تتوفر معلومات مسبقة.

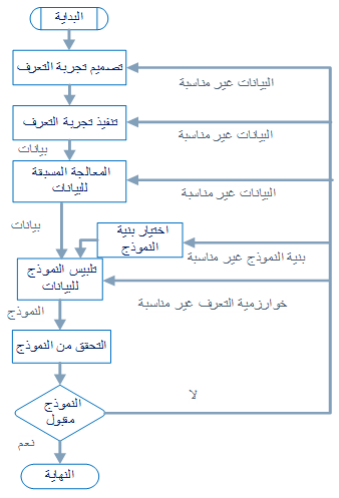
[picture p50: figure]

29

.4 تحديد قواعد تقي يم النموذج، وتعتمد على مدى مقدرة النموذج على إعادة انتاج البيانات المقاسة. مثل معيار كلفة خطأ التقدير وهو مجموع مربعات خطأ التقدير )الفرق بين الخرج المقدر والخرج المقاس(،
.5 التحقق من جودة النموذج ، وهي خطوة مهمة للتأكد من أن النموذج التجريبي مقبول بالنسبة للهدف الذي سيستخدم ألجله. لذلك يجب الخوض بخطوات أعمق
من معيار كلفة الخطأ بحساب معامل االرتباط الذاتي للبواقي واالرتباط المتبادل للدخل مع البواقي للتأكد من قدرة النموذج على تفسير كامل طيف إشارة الدخل.

يتضمن تصميم تجربة التعرف مسائل مثل اختيار اإلشارات المراد قياسها و زمن تعيينها و توصيف إشارات اإلثارة المستخدمة. إذا كان النظام خطي ووحيد الدخل والخرج فإن إشارة الدخل يجب أن تغطي كامل المجال الترددي الذي يعمل عليه هذا النظام. و بمجرد تسوية هذه المسائل، يمكن إجراء تجربة التعرف الفعلية وجمع البيانات العملية. تأتي بعدها مسألة اتخاذ قرار بشأن هيكل نموذج مناسب. هذ ه ال خطوة حاسمة في عملية التعرف والحصول على نموذج جيد ومفيد، و يجب أن تتم بعناية. بالنظر إلى بنية النموذج المناسبة والبيانات المقاسة، يمكننا بعدها أن ننتقل إلى التقدير الفعلي لمعامالت النموذج. إلجراء ذلك توجد أدوات برمجية ذات أغراض خاصة تتسم بالكفاءة وسهولة االستخدام مثل صندوق أدوات التعرف المقدم من شركة ماتالب ، ما يسهل تنفيذ هذه الخطوة. قبل أن يتم اعتماد النموذج، يجب أن يجتاز بعض اختبارات التحقق من الصحة. يمكن القول بأن التحقق من صحة النموذج ي عتمد على مسألة ما إذا كان النموذج األفضل جيد بما يكفي لالستخدام

شكل -23مراحل تنفيذ عملية التعرف

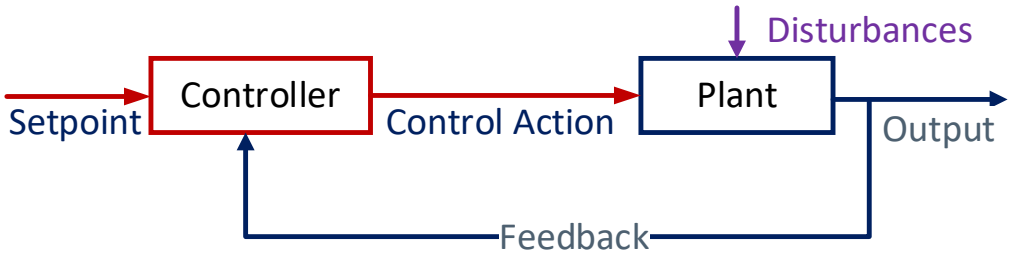
[picture p51: figure]
Controller; Plant; Control Action; Output; Feedback; Setpoint; Disturbances

30

المقصود. من ضمن أدوات التحقق الشائعة هي المقارنة بين خرج النموذج مع الخرج الحقيقي. حيث تتم محاكاة النموذج باستخدام بيانات جديدة غير البيانات المستخدمة في تقدير النموذج ً هناك عمليات

ومقارنة خرج النموذج بالخرج المقاس وإيجاد نسبة تلبيس النموذج المئوية. أيضا تحليل البواقي، و دراسة االرتباط الذاتي له، كذلك االرتباط المتبادل ما بين البواقي وإشارة الدخل للتأكد من خلو البواقي من أية ارتباطات مع الدخل. إذا فشل النموذج في اجتياز اختبارات التحقق من الصحة، فيجب تكرار بعض الخطوات المذكورة أعاله أو كلها حتى يتم العثور على نموذج يجتاز اختبارات التحقق من الصحة. يهدف هذا الفصل إلى التعرف على نظام المخدم الكهروهيدروليكي من خالل تقدير نماذج معامالتية تفيد في التحكم والمحاكاة، وسيتم االعتماد على خرج هذه المرحلة في عملية تصميم المتحكمات المناسبة لحلقة الموضع والتسارع والتي سيتم شرحها في الفصل التالي.

### 3.2 التعرف في الحلقة المغلقة:

سيتم تطبيق إجرائية التعرف على النظام في الحلقة المغلقة التي تستخدم التغذية العكسية لتغيير سلوك األنظمة الديناميكية. يكون الهدف، على سبيل المثال، تحسين سرعة استجابة النظام، أو جعله أقل حساسية إلى االضطراب أو الضجيج. يبين الشكل )24( البنية األساسية لنظام في الحلقة المغلقة، حيث تم ربط النظام بمتحكم من خالل تغذية عكسية. يعطي المتحكم دخل إلى النظام وإذا كان هناك مزيد من اال ضطراب في خرج النظام سيعود إلى المتحكم كدخل بعد تطبيق المعامالت و الذي يعود مرة أخرى إلى النظام وتستمر العملية لطالما لم يتحقق الخرج المطلوب .

شكل -24البنية األساسية لنظام في الحلقة المغلقة
في معظم األنظمة، يتم التعرف في الحلقة المفتوحة ولكنه غير ممكن في بعض الحاالت ، لذلك نلجأ إلى الحلقة المغلقة ألنها تضعف من تأثير االضطراب . هناك عدد من الحاالت تستدعي تطبيق التعرف في الحلقة المغلقة:

31

✓ النظام غير المستقر ال يمكن تعريفه أو اختبار ه في الحلقة المفتوحة. ✓ يتطلب تطبيق قيود التشغيل استخدام الحلقة المغلقة في كثير من األحيان. ✓ يحافظ متحكم الحلقة المغلقة على إبقاء النظام في جوار نقاط العمل المرغوبة. ً ما يتطلب هذا مواكبة معامالت النموذج لتغي ارت سلوك النظام مع

✓ إذا كان النظام يتغير زمنيا الزمن.

### 3.3 إشارات التحفيز المستخدمة في التعرف:

يوجد عدد كبير من اإلشارات التي يمكن استخدامها في إجرائية التعرف على األنظمة منها: .1 اإلشارة النبضية (Signal Impulse(: عبارة عن إشارة قصيرة وقوية وتحمل طيف جيد من الترددات التي يمكن أن تحفز ديناميك النظام.
.2 اإلشارات الجيبية.
.3 إشارة الضجيج األبيض ) Signal Noise White): هي إشارة عشوائية ذات طيف تردد ثابت تستخدم الختبار استجابة النظام. .4 إشارة ال Sweep Sin : هي إشارة جيبية متغيرة التردد مع الزمن، حيث تبدأ عند تردد ً إلى ترددات أعلى. تستخدم لتحليل استجابة األنظمة عبر نطاق

منخفض وتزداد تدريجيا
واسع من الترددات. تعرف أيضا Signal Chirp". | ً ب "
:)Pseudo-Random Binary Sequence( PRBS | المزيفة | العشوائية | الثنائية | السلسلة | .5
هي إشارة ثنائية تتكون من سلسلة من األصفار والواحدات يتم توليدها بترتيب يبدو ُستخدم

ا يمكن إعادة إنتاجه. ت
ً

ا، لكنها في الحقيقة تتبع نم ًطا معين ً

عشوائي PRBS في
اختبارات األنظمة للتحقق من استجابتها والتأكد من أدائها.

32

### 3.4 اإلشارة الثنائية العشوائية المزيفة PRBS :

تم اعتماد السلسلة الثنائية العشوائية المزيفة BRP ألنها تملك طيف عريض شبيه بالطيف العشوائي يمكن التحكم به ليغطي أنماط عمل النظام [5]. يتم اختيار أعلى تردد تتغير فيه اإلشارة لكي يسمح بتحصيل ما بين 10 إلى 15 عينة خالل فترة زمن االستقرار[5]. بالنسبة لمطال هذه اإلشارة فيجب أن يكون في حدود نقطة العمل المرغوبة والتي يحددها شروط تشغيل النظام المطلوبة. ويتفرع عن حالة النظام الخطي حالة النظام متعدد الدخل والخرج ويجب على عينات الدخل أن تغطي كامل مجال التردد ولكن أن تكون مستقلة عن بعضها البعض. الحالة الثانية عندما يكون النظام الخطي ففي هذه الحالة يجب أن يكون لدينا إشا ارت دخل تغطي كامل نقاط العمل المرغوبة.
ً على سبيل المثال من أجل توليد هذه اإلشارة ويمكن

يتم توليد اإلشارة الثنائية العشوائية برمجيا استخدام صندوق أدوات ماتالب [6] لتوليد هذه اإلشارة باستخدام التابع .upnidi

idinput([Period, NumCℎannel, NumPeriod], ′prbs′,Band, Range)
1 − n حيث أن n تمثل مرتبة الـPRBS. | طولها األعظمي يحدد بـ 2
دور اإلشارة الكامل يجب أن يكون أقل أو يساوي طولها األعظمي.

Range = [min max];
Band = [0 B];
B هو مقلوب دور ساعة الـPRBS. من أجل تحقيق إثارة مطبقة على دخل النظام المراد التعرف عليه يجب تحقيق ما يل ي: ✓ أن تحتوي إشارة الـPRBS المستخدمة في إثارة النظام على نبضات طويلة األمد )تردد منخفض( تعالج وتفسر استجابة الحالة المستقرة )الربح (. إن أكبر عرض نبضة يتم توليده بواسطة إشارة الـPRBS يعطى بالعالقة:

Tmax = n × Tclck

33

ً إشارة الـPRBS على نبضات قصيرة المدى تفيد في التقاط وتفسير

✓ وأن تحتوي ايضا
ديناميكيات النظام للحالة العابرة. إن أقصر نبضة يتم توليدها بواسطة مولد إشارة الـPRBS هي بعرض دور ساعة الـPRBS :

Tmin = Tclck
وبالتالي يكون طيف إشارة هو :

[

1

n ∗ Tclck

~

1

Tclck

]
ويجب أن يحوي عرض حزمة النظام المدروس.
بناءا اإلشارة ودور الساعة يمكن حساب الزمن الذي تستغرقه تجربة التعرف : | ً على طول

time = (2

N − 1) × Tclck
كما ذكر سابقا سيتم تركيب اإلشارة فوق إشارة الSetpoint في الحالة المستقرة )نقطة التشغيل(، | ،ً
وبالتالي سيتراوح مطال إشارة الـPRBS حول نقطة التشغيل بنسبة معينة:

umin ≤ u(t) ≤ umax
مع مراعاة القيود المادية على المشغالت وتجنب االستجابة الالخطية للنظام.

### 3.5 تصميم تجربة التعرف:

يعتمد تصميم التجربة على الخبرة الفيزيائية التي تتوفر لدينا عن النظام[7] . إن مصدر هذه المعرفة هو النموذج الفيزيائي الذي يتم استخراجه من القوانين الطبيعية، مثل قانون نيوتن لديناميك األنظمة الميكانيكية. هذه النماذج الفيزيائية يتم وصفها بواسطة المعادالت التفاضلية المستمرة. أو من خالل تحصيل نموذج استجابة القفزة للنظام.

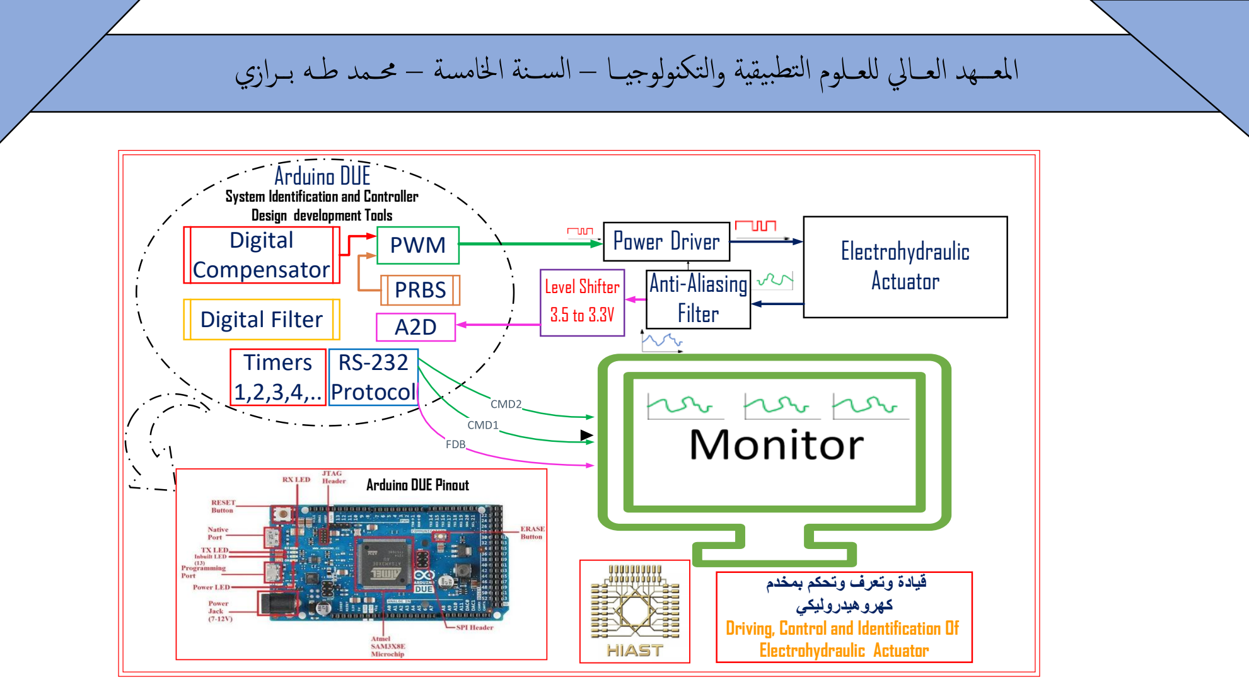
[picture p52: figure]
Timers 1,2,3,4,..; RS-232 Protocol; PWM; Power Driver; Electrohydraulic Actuator; Digital Compensator; Digital Filter; Anti-Aliasing Filter; Of Identification and Control ,Driving; كهرو يدروليك; ياد وت ر وتحك مخد; Level Shifter; 3.5 to 3.3V PRBS; Arduino DUE Pinout; Arduino DUE

34

System Identification and Controller Design development Tools

شكل -25آلية إرسال واستقبال األوامر من وإلى المتحكم في تجربة التعرف
يوضح الشكل)25( آلية إرسال واستقبال األوامر من وإلى المتحكم في تجربة التعرف. يقوم المتحكم DUE بإرسال إشار ات الدخل والتي هي عبارة عن إشارة الـPRBS( المولدة باستخدام ماتالب( المضافة إلشارة ال Setpoint و التي يتم إرسالها على شكل إشارة PWM، بعدها يتم حساب إشارة الخطأ وإرسال قيمة األمر المناسبة لدراة القيادة والتي بدورها تقوم بإثارة المخدم ضمن منطقة العمل الخطية له. يقوم المخدم يتحريك الطاولة بحركة خطية نحو الموضع المطلوب، وفي هذه األثناء تتغير قراءة عنصر التغذية العكسية )مقسم الجهد( بما يتناسب مع حركة الطاولة. يستقبل مرشح
H100 = إشارة الموضع ما يحجب الترددات التي تقع خارج | تمرير منخفض بتردد قطع
مجال استجابة المخدم )الضجيج العشوائي(. بعدها تصل اإلشارة إلى مدخل دارة اإلزاحة من أجل مالئمة مستوى اإلشارة مع دخل المحول )v3.3~0). تصل اإلشارة المفيدة جاهزة إلى مدخل
esm2 = . ويقوم المتحكم | المحول التشابهي الرقمي فيقوم بتقطيع هذه اإلشارة بدور تقطيع
بتسجيل اإلشارة وترشيحها باستخدام مرشح رقمي نوع الوسطي المتحرك. ويقوم المتحكم بعدها ببث كل من بيانات إشارة الدخل والخرج المرشحة إلى الحاسب عبر منفذ االتصال التسلسلي من أجل التخزين والمعالجة الالحقة.

35

### 3.6 إجرائية تنفيذ التعرف التجريبي:

بعد تنفيذ تجربة التعرف وجمع البيانات ومعالجتها يتم اختيار النموذج

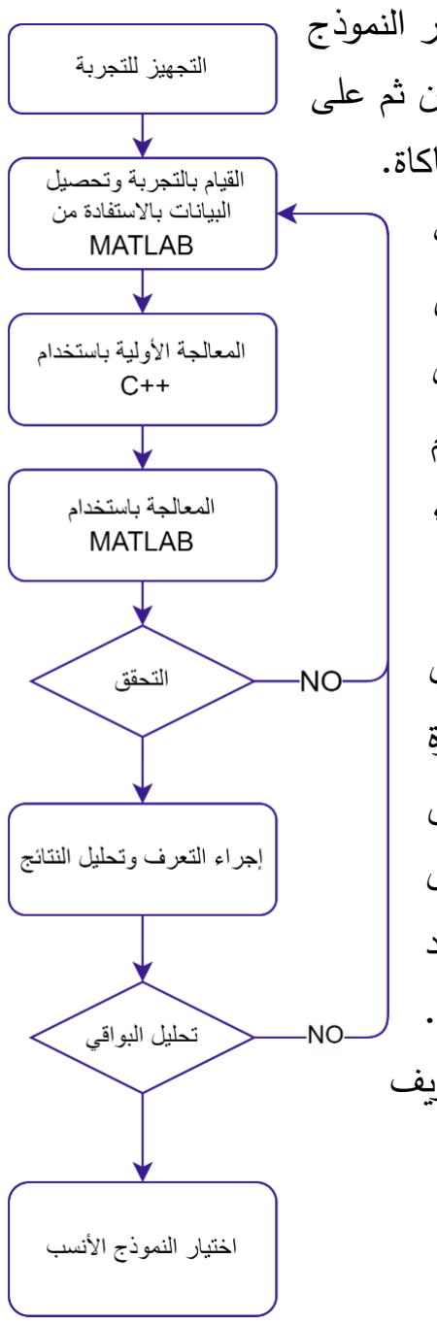
[picture p53: figure]

المطلوب والذي يعتمد على المعلومات المسبقة عن النظام أوالً ومن ثم على الهدف من النموذج على سبيل المثال نموذج تقدير أو نموذج محاكاة. بعدها يجب أن نتطلع إلى معيار لتقدير المعامالت ونستخدم لذلك معيار خطأ التقدير ]4[ وهو مجموع مربعات خطأ التقدير والذي يمكن أن ينتج عنه تقدير معامالت النموذج. بعد تحصيل كل المعامالت نستعرض النموذج و نتحقق من النموذج باستخدام بيانات التحقق و نقارن بين بيانات االستجابة المعروفة، و أخطاء تقدير المعامالت ]5[.
بعد كل هذه المراحل من اإلجراء، ن تحقق إذا كان النموذج مقبول نستخدمه و إذا لم يكن مقبول، نعود في اإلجرائية إلى الخطوة السابقة أو التي تسبقها من أجل تعديل معامالت النموذج و نتحقق من النموذج مرة ثانية. ن نفذ اإلجرائية مر ات عديد ة إلى أن يتم قبول
ً | النموذج ويصبح قيد االستخدام، العودة إلى توليد

من الممكن ايضا
البيانات من جديد إذا تبين أنها ال تغطي طيف ديناميك النظام. ووفق هذه الخوارزمية يمكن بسهولة أن نستنتج أن إجرائية تعريف النظام هي إجرائية تكرارية.

شكل -26مراحل تنفيذ التعرف التجريبي

36

### 3.7 برنامج المتحكم الصغري في تجربة التعرف:

بعد إحكام الحلقة المغلقة تم تشكيل إشارة التحفيز وهي إشارة ال PRBS والتي يتم إضافتها
إلى القيمة المرغوبة Setpoint عند مدخل حلقة التحكم ثم يتم حساب الخطأ، وبعدها يتم تنفيذ معادلة التحكم وإرسال أمر التحكم للمخدم. سيناريو تجربة التعرف المعتمد هو توضيع المخدم عند منتصف الشوط، والذي يعتبر نقطة التشغيل األساسية، أوالً ومن ثم يتم تحركه حول نقطة التشغيل بمطال محدد يتعلق بمطال إشارة التحفيز. دث قيم إشارة

ُحّ

إلحكام زمن الحلقة، يتم استخدام مقاطعة المؤقت الزمني بدور ms،2 وت ا لدورة الساعة

clc المحددة في بداية العملية. | التحفيز باستم ارر وفق | ً
ا للحجم الكبير إلشارة
ً

نظر التحفيز، والذي يستهلك قسم كبير من الذاكرة، ي تم استخدام ذاكرة الفالش المتاحة في المتحكم باستخدام تعليمة EMGORP. ا ً

رغم أن هذا األسلوب يحقق توفير
ملحو ًظا في استهالك الذاكرة، فإنه ال يتيح إمكانية التعديل على البيانات المخزنة، أثناء تنفيذ البرنامج و هذا ال يؤثر على طبيعة استخدامنا للذاكرة التي ال نحتاج إلى تغييرها. يوضح الشكل )27( خوارزمية عمل المتحكم في تجربة التعرف:

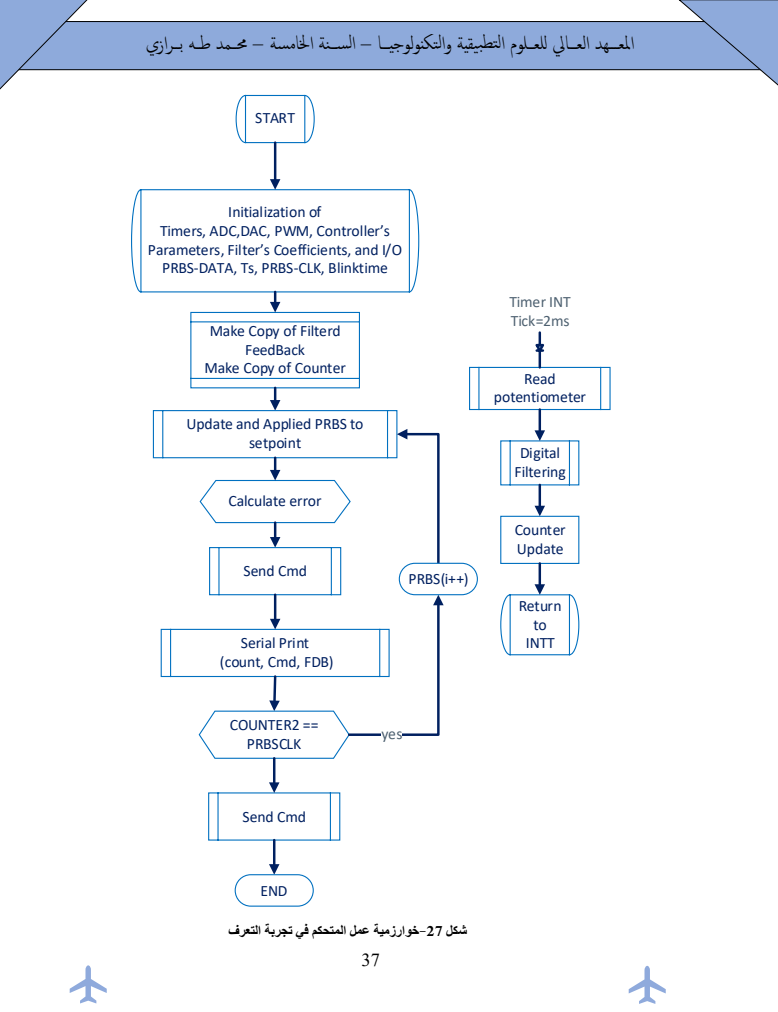
[picture p54: page 49]
START; Initialization of; Calculate error; Send Cmd; COUNTER2 == PRBSCLK; Digital Filtering; Timer INT Tick=2ms; END; Counter Update; Return to INTT; yes; PRBS(i++)

Timers, ADC,DAC, PWM, Controller s
Parameters, Filter s Coefficients, and I/O
PRBS-DATA, Ts, PRBS-CLK, Blinktime

Make Copy of Filterd
FeedBack
Make Copy of Counter

Read potentiometer

Update and Applied PRBS to setpoint

Serial Print
(count, Cmd, FDB)

شكل -27خوارزمية عمل المتحكم في تجربة التعرف

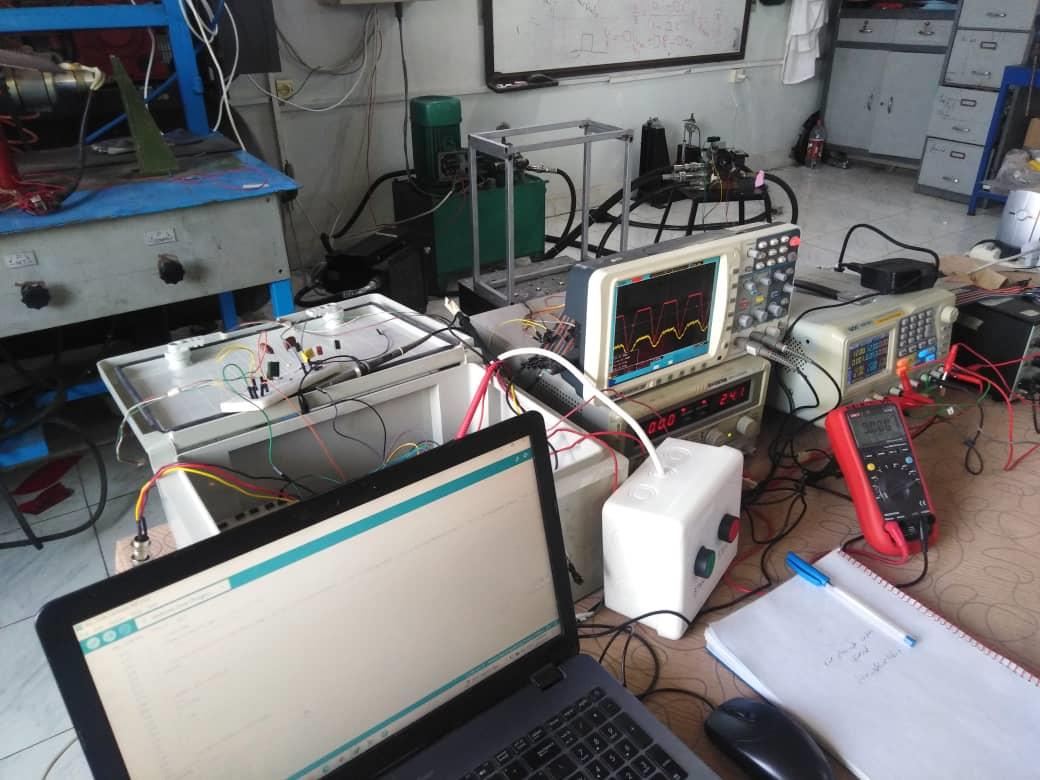
[picture p55: figure]

38

### 3.8 تحليل النتائج ومناقشتها:

قبل أن نستعرض النتائج البد من عرض صورة عن بيئة عمل تجربة التعرف. تعرض الصورة )9( بيئة تجربة التعرف التي تتكون من: منصة التحكم الرقمي بما فيها: بطاقة المتحكم ARM المسمى DUE من شركة Arduino. دارة مرشح التمرير المنخفض )مانع التراكب( بين خرج ال potentiometer ودخل دارة المالئمة التي تالئم مستوى الجهود لتصبح v3.3 مناسبة لدخل المحول D/A. دارة القيادة التي تستقبل إشارات التحكم PWM وتقوم بتأمين التغذية المناسبة للصمامات. دار ة تأمين التغذية V+10 من المنبع +12 . التجهيزات المستخدمة بما فيها: منبع التغذية مستمر.
راسم اإلشارة الرقمي.
أسالك توصيل متنوعة.

صورة -10صورة عن بيئة العمل وعرض بيانات الدخل والخرج أثناء التحصيل


39

شكل -28الواجهة التخاطبية لصندوق أدوات تعريف النظام في ماتالب
يظهر الشكل )28( .found not source Reference! Errorالواجهة التخاطبية لصندوق أدوات تعريف النظام في ماتالب التي تم استخدامها في تقدير نماذج التعرف التجريبي على المخدم الكهروهيدروليكي في الحلقة المغلقة. في إطار تطبيق التعرف التجريبي على نظام المخدم الكهروهيدروليكي ، تم إجراء التجارب التالية: 1( تجربة التعرف على نموذج التحكم Model Process استخدمت فيه إشارة تحفيز نبضية.
2( تجارب التعرف التنبؤ والنمذجة والمحاكاة وفق الطريقة المباشرة واستخدمت فيها إشارة تحفيز من نوع PRBS طبقت فيه إشارة التحفيز على مدخل حلقة التحكم.

### 3.9 تجربة التعرف على نموذج التحكم Model Process:

في أول تجربة تعرف حسب الطريقة المباشرة تم تحفيز النظام عند مدخل حلقة التحكم. تم
تطبيق إشارة تحفيز عبارة عن قطار من النبضات تمثل قفزات متتالية بدور 1 = وديمومة %50 وبمطال [1200-2800] وتحصيل االستجابة فكانت كما في الشكل )29(:

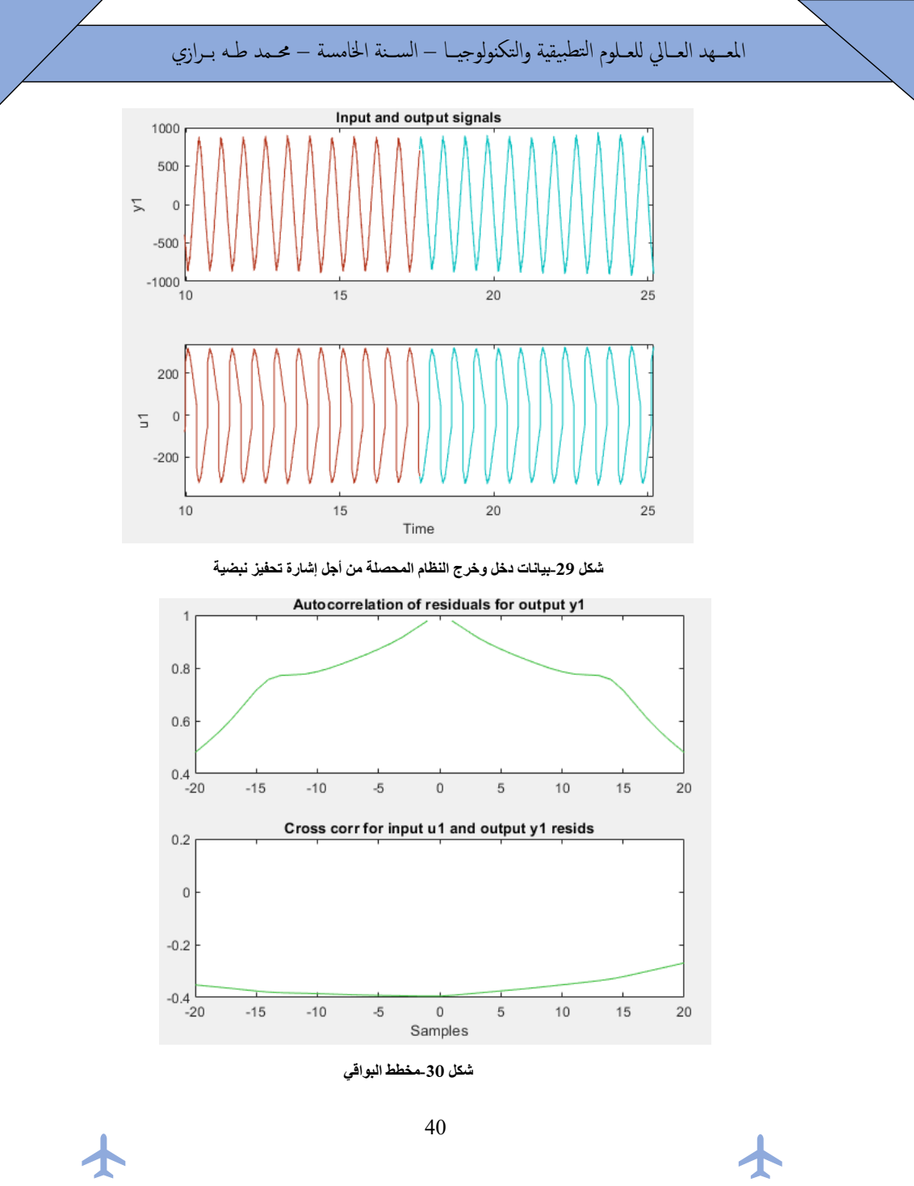
[picture p56: page 52]

40

شكل -29بيانات دخل وخرج النظام المحصلة من أجل إشارة تحفيز نبضية

شكل -30مخطط البواقي

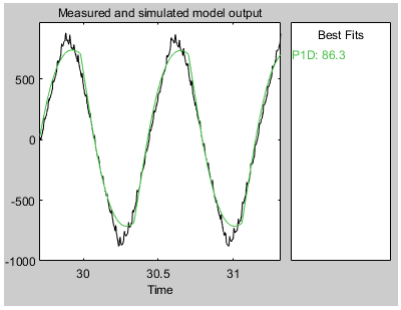
[picture p57: figure]

41

النموذج الناتج عن التعرف له هيكل إجرائية Model Process:

G(s) =

Kp
(1+Tps)

e

−Tds

Kp = 1

Tp = 0.313 sec

Td = 0.167 sec

G(s) =

1
(1+0.313s)

e

−0.167s

Estimation fitting = 81%

شكل -31نسبة الباس نموذج Model Process المقدر لبيانات التحقق

### 3.10 تجارب التعرف على نماذج التنبؤ والنمذجة والمحاكاة:

الهدف من هذه التجارب تحصيل نماذج خطية والخطية يمكن استخدامها في التنبؤ والنمذجة والمحاكاة ولكن قد أظهرت النتائج عدم قدرة النماذج الخطية على تفسير إشارة الدخل والخرج و بالتالي لم تقدم نماذج خطية تعبر عن سلوك النظام المدروس وذلك بسبب وجود العناصر الالخطية )التأخير الزمني الكبير - المنطقة الميتة - السلوك غير المتناظر لحركة الطاولة( التي طغت على سلوك النظام مما أدى إلى استحالة تحصيل نموذج خطي.

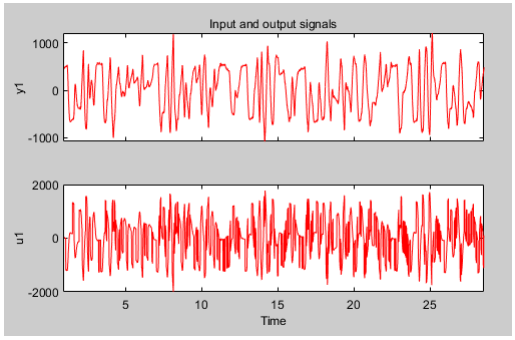
[picture p58: figure]

42

ً | لذا تم اللجوء إلى البحث عن نماذج الخطية فكانت النتائج ما ولكن ما ازلت غير قادرة

جيدة نوعا
على تفسير كامل سلوك النظام ويعود السبب كذلك إلى الالخطية الكبيرة التي يعاني منها النظام ويبدو أن النماذج المتاحة غير قادرة عن تفسير هذا السلوك. سيتم استعراض بيانات التجارب )الشكل)32(( التي تم إجراءها مع أفضل النماذج المحصلة منها.
ً | في هذه التجارب تم اقحام إشارة التعرف PRBS على مدخل حيث تم

حلقة التحكم كما ذكر سابقا
إضافتها إلى إشارة ال Setpoint( وهي تساوي 50% من طول الشوط أي مايقابل 2000 كإشارة مقروءة من المتحكم ( بمطال وبدور ساعة متغير حسب التجربة. -1 إشارة PRBS بمطال يتناوب بين ±10% من طول الشوط الكلي للمكبس وما يكافئه [−400,400] كإشارة مقروءة من المتحكم DUE، بتردد تقطيع m 2 وبدور ساعة m 28 وبما أن طول اإلشارة elpmas 1023 هذا ما يجعل زمن التجربة 29~.

شكل -32بيانات دخل وخرج النظام المحصلة من أجل إشارة تحفيز PRBS
تم تجربة عدة نماذج من أجل تحصيل نموذج من البيانات السابقة ولكن جميع النماذج قدمت نتائج غير مرضية وأفضلها كان نموذج خطي من نوع Function Transfer ونموذج الخطي يدعى Wiener-Hammerstein يصف هذا النموذج كما هو موضح في الشكل )33(، ديناميك نظام باستخدام واحد أو أثنين من البلوكات الالخطية الساكنة على التسلسل مع بلوك خطي.

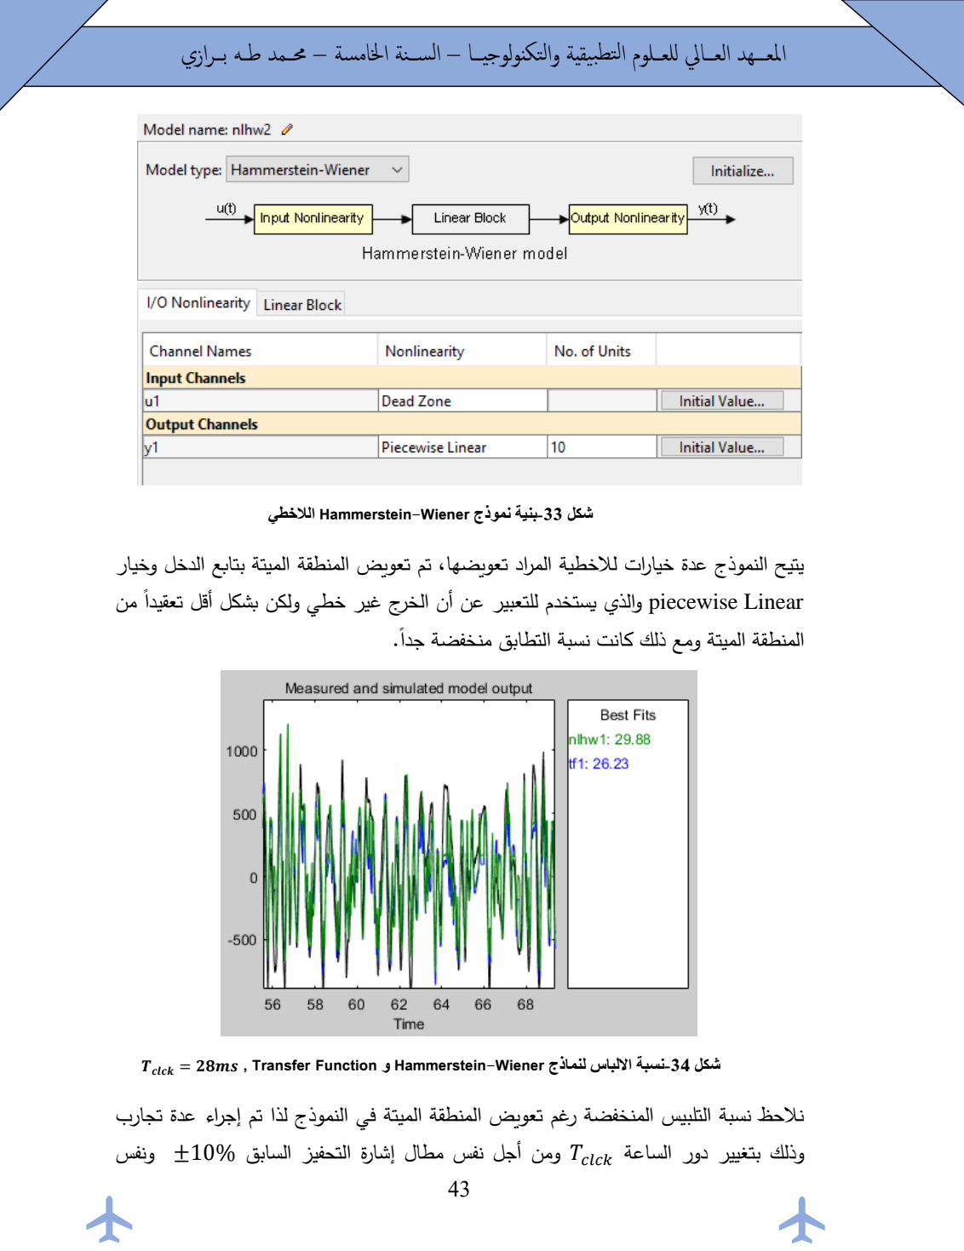
[picture p59: page 55]

43

شكل -33بنية نموذج Wiener-Hammerstein الالخطي
يتيح النموذج عدة خيارات لالخطية المراد تعويضها، تم تعويض المنطقة الميتة بتابع الدخل وخيار ً من

Linear piecewise والذي يستخدم للتعبير عن أن الخرج غير خطي ولكن بشكل أقل تعقيدا المنطقة الميتة ومع ذلك كانت نسبة التطابق منخفضة جدا. ً

شكل -34نسبة االلباس لنماذج Wiener-Hammerstein و Function Transfer ,Tclck = 28ms
نالحظ نسبة التلبيس المنخفضة رغم تعويض المنطقة الميتة في النموذج لذا تم إجراء عدة تجارب وذلك بتغيير دور الساعة clcT ومن أجل نفس مطال إشارة التحفيز السابق ±10% ونفس

44

طول اإلشارة elpmas 1023 وذلك من أجل الحصول على نسبة تطابق أعلى وكانت النتائج كما يظهر الجدول)2( التالي:

جدول -2نسب التطابق لنماذج Wiener-Hammerstein وFunction Transfer من أجل 10=N و

clcT متغيرة
clc نحصل على نسبة تلبيس أفضل وذلك يعني أن | نالحظ من البيانات السابقة أنه بتخفيض
m01 = clc هو = 1 ∗ 1 = clcT ∗ | أطول عرض نبضة سيكون في حالة
ً غير كافي لوصول النظام للحالة المستقرة والتي يظهر فيها تأثير

001 وهذا الزمن فعليا
المنطقة الميتة بشكل واضح كخطأ حالة دائمة متغير ، وبالتالي كل ابتعدت استجابة النظام عن الحالة المستقرة زادت نسبة التلبيس وقل أثر المنطقة الميتة ولكن هذا األمر سينتج عنه نموذج قادر على تفسير ديناميك النظام في الحالة العابرة فقط دون الحالة المستقرة المهيمنة عليها المنطقة الميتة.
لذا تم تعديل مطال وطول إشارة التحفيز من أجل تخفيض أثر المنطقة الميتة ما أمكن وزيادة زمن التجربة من أجل الحصول على قدر أكبر من المعلومات التي تفيد في تفسير سلوك النظام. سيتم استعراض نتائج التجارب من أجل طول إشارة elpmas 4095 = tib12 = ومطال ±13% وفق الجدول التالي :
| Hammerstein-Wiener | Transfer Function
Tclck | Estimation Fit | Validation Fit | Estimation Fit | Validation Fit
50ms | 44.69% | 44.85% | 17.72% | 26.56%
40ms | 46.82% | 47.23% | 44.56% | 47.45%
30ms | 58.41% | 50.76% | 34.1% | 33.57%
22ms | 46.74% | 43.41% | 33.86% | 33.14%
14ms | 59.54% | 52.76% | 40.68% | 38.81%
12ms | 54.75% | 56.1% | 43.67% | 44.09%
10ms | 57.53% | 57.34% | 47.68% | 49.66%

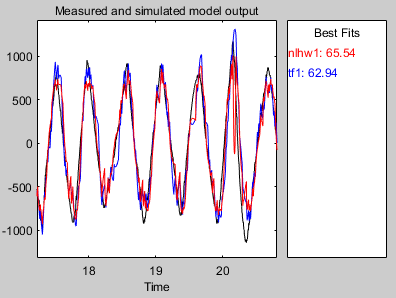
[picture p60: figure]

45

| Hammerstein-Wiener | Transfer Function
Tclck | Estimation Fit | Validation Fit | Estimation Fit | Validation Fit
10ms | %54.64 | 55.93% | 53.18% | 47.93%
8ms | 63.97% | 63.67% | 56% | 55.25%
6ms | 65.96% | 61.01% | 40.43% | 62.94%
جدول -3 نسب التطابق لنماذج Wiener-Hammerstein وFunction Transfer من أجل 12=N و

clcT متغيرة
نالحظ تحسن في نسبة التلبيس بعد زيادة مطال اإلشارة وطولها.

شكل -35 نسبة االلباس لنماذج Wiener-Hammerstein و Function Transfer ,Tclck = 28ms
ُ | عند

إج ارء معاينة بصرية للنتائج، يالحظ أن نسبة التطابق المنخفضة سببها هو أن النموذج حساس للضجيج بشكل كبير، ولكن نالحظ ان النموذج قادر على تفسير ديناميك النظام بشكل جيد لذا يعتبر النموذج مقبول.

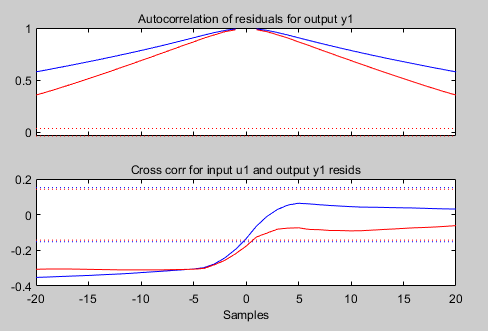
[picture p61: figure]

46

شكل -36تحليل البواقي لنماذج Wiener-Hammerstein و Function Transfer
وللتحقق من مدى تفسير النموذج لبيانات الدخل-الخرج تم تفحص البواقي في الشكل)36( يحمل مخططين، العلوي هو تابع االرتباط الذاتي للمتبقي ويظهر أن البواقي ليست عشوائية بالكامل ألنه يوجد ارتباط بين عينات البواقي ذاتها. أما المخطط السفلي فهو االرتباط المتبادل بين المتبقي وإشارة الدخل. ومن الواضح أن هناك ارتباط سلبي بين المتبقيات وإشارة الدخل ما يفسر نسبة التلبيس المنخفضة ألنه التزال هناك بعض البيانات الني لم يستطع النموذج تفسيرها. يحتوي الجزء الخطي من نموذج Wiener-Hammerstein على صفرين وثالث أقطاب وتأخير زمني:

شكل -37 مكونات الجزء الخطي من نموذج Wiener-Hammerstein

Estimation Data: ′6ms13%de′ witℎ 5221 samples. Model Configuration:
Input nonlinearity: Deadzone.

47

Output nonlinearity: Piecewise linear witℎ 10 units and unspecified break − points.
اليوجد شكل صريح للنموذج وإنما هو عبارة عن Block يتكون من الجزء الخطي والالخطي يمكن
تصديره إلى Workspace الخاصة بماتالب ومن ثم استيراه في Simulink من أجل التعامل
معه.

شكل -38نمذجة نموذج Wiener-Hammerstein في Simulink
أما بالنسبة لنموذج Function Transfer فهو يملك الشكل التالي:

G(s) =

16.99 s + 49.92
s

2 + 21.26 s + 172.2
يجب ذكر أنه تم إجراء تجارب تم فيها إضافة قيمة ثابت مساوية لقيمة المنطقة الميتة إلى إشارة دخل النظام بهدف تقليل أثر المنطقة الميتة ما أمكن ولكن بقيت نسبة االلباس منخفضة مما يعني عدم فعالية الحل المقترح. لذا يجب البحث في التقنيات المستخدمة في التعرف على هذا النوع من األنظمة الذي يعاني من الالخطية الكبيرة وتجربة تطبيق أنواع أخرى من إشا ارت التحفيز.

48

# الفصل الرابع: التحكم بالمخدم

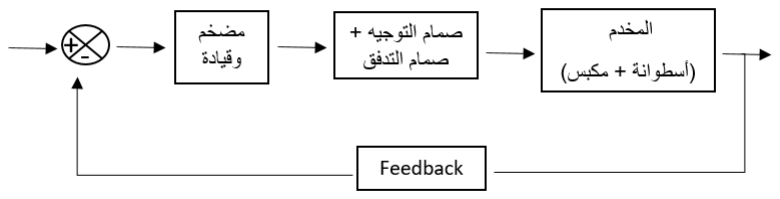
[picture p62: figure]

49

### 4.1 مقدمة:

تعتبر أنظمة التحكم هي أنظمة صنع القرار، حيث تستند القرارات إلى تنبؤات السلوك المستقبلي المستمدة من نماذج األنظمة المراد التحكم فيها، وعلى المالحظات التي تم الحصول عليها من أجهزة االستشعار للسلوك الفعلي. تؤثر التطورات في تكنولوجيا المستشعرات والمشغالت ً ما

على منهجية التحكم، والتي تتأثر أيضا تكون | ً بتوافر موارد حسابية منخفضة التكلفة وعادة
،ً بينما قد تتوفر معلومات أقل حول سلوكها الديناميكي.

األنظمة التي يجب التحكم فيها أكثر تعقيدا إن تطوير منهجيات التحكم لمواجهة هذه التحديات تتطلب أفكا ارً جديدة ومتعددة التخصصات، باإلضافة إلى تطوير وتحسين األساليب الحالية.
ًة بحلقة تحكم واحدة ومن ثم | الهدف من هذا البحث م

هو قيادة المنظومة والتحّك بالموضع بداي
التحكم بالتسارع والموضع باستخدام حلقتي تحكم وهو ما يسمى بالتحكم التتابعي ) Cascade

Control )ن.
ّ

بحيث يكون المتحّكم قاد ارً على تحقيق دفتر شروط معي

### 4.2 نمذجة النظام المدروس باستخدام برنامج المحاكاة Simulink\MATLAB:

قبل الدخول في تجارب األداء يجب معرفة السلوك الديناميكي للجملة بشكل أولي باستخدام برنامج المحاكاة. ولنمذجة الدارة يجب التعرف على حلقة التحكم بالمخدم الهيدروليكي، والتي تتألف من األقسام الموضحة في الشكل التالي:

شكل -39حلقة التحكم بنظام المخدم الكهروهيدروليكي
إن تابع النقل الذي تم تحصيله من عملية التعرف في الفصل السابق يعبر عن تابع النقل لكامل الحلقة المفتوحة في المسار األمامي. بعد إجراء تقريب على التأخير الزمني واستبداله بقطب )حسب تقريب باديه( وإضافة مكامل من أجل تحصيل إشارة الموضع يصبح شكل التابع التحويلي للنظام كامالً وفق الشكل )40(:

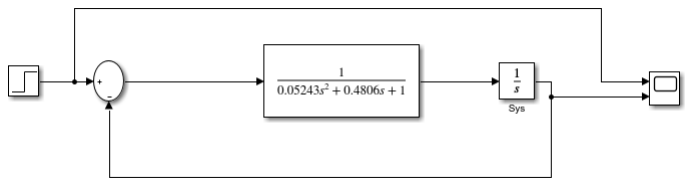
[picture p63: figure]
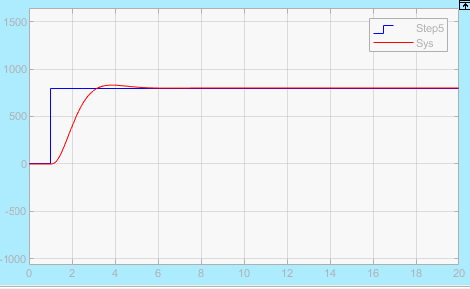
[picture p64: figure]

50

شكل -40نمذجة النظام باستخدام برامج Simulink\MATLAB
يوضح الشكل )41( استجابة النظام من أجل دخل قفزة m15 = nuoc 800 = ets ، ويجب ذكر أنه تم تحديد شوط العمل من mm]50~20 [حيث وجد من خالل التجارب أنه أفضل مجال يكون فيه تأثير االحتكاك وعدم التناظر بين شوط الذهاب وشوط العودة أقل مايمكن.

شكل -41 محاكاة استجابة النظام من أجل دخل قفزة
:Non-Linear Items | الالخطية | العناصر | 4.3
من الشائع وجود عناصر الخطية ما في ّ

في أغلب األنظمة العملية وال سي الهيدروليكية منها، والتي ّع بعنصرين ال خطي

تتمت ي ن مهمين وهما المنطقة الميتة (zone Dead (والتأخير الزمني (delay Time(، باإلضافة إلى عنصر اإلشباع (Saturation(.

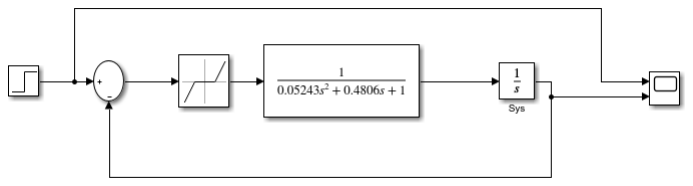
[picture p65: figure]

51

4.3.1 المنطقة الميتة (zone Dead(:
بشكل عام، يمكن تعريف المنطقة الميتة بأنها المجال الذي ال يستجيب عنده النظام بالرغم من وجود جهد دخل مطبق عليه، أي بشكل آخر هي المجال الذي ال يوجد فيها جهد على خرج النظام بالرغم من تحديد مجال جهد المنطقة الميتة من خالل التجارب ّ

تطبيق جهد دخل عليه، وسوف يتم عَّبر عن المنطقة الميتة بالعالقة التالية: ُ

ة، وي
ّ

العملي

y = {

X − D ;X > D
0 ; − D < X < D
X + D ;X < −D

من خالل القيام بتجارب عديدة في نمط الدارة المفتوحة

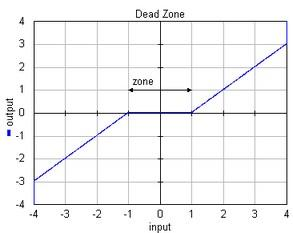
[picture p66: figure]

ً وم ارقبة حركة

أمكن تحديد مجال المنطقة الميتة وذلك من خالل إرسال أوامر جهد صغيرة جدا المخدم وعند بدء المخدم بالحركة تم قراءة قيمة التيار وتوصيف المجال ووجد أنه أصغر قيمة تيار يبدء عنده المخدم بالحركة هو m 335 = DI وهو ما يقابل كجهد دخل lov 1.4 = DV من أصل lov 12 وهي تمثل تغذية صمام تخفيض الضغط التناسبي. تم اعتماد قيمة المنطقة الميتة كقيمة رقمية مقروءة من المتحكم 470 = noZdaeD. 4.3.1.1 أثر المنطقة الميتة على سلوك النظام: تم نمذجة المنطقة الميتة لمراقبة أثرها على سلوك النظام وفق الشكل)43(:

شكل -43نمذجة المنطقة الميتة

شكل -42تعريف المنطقة الميتة

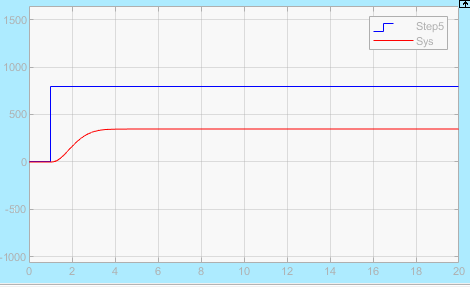
[picture p67: figure]
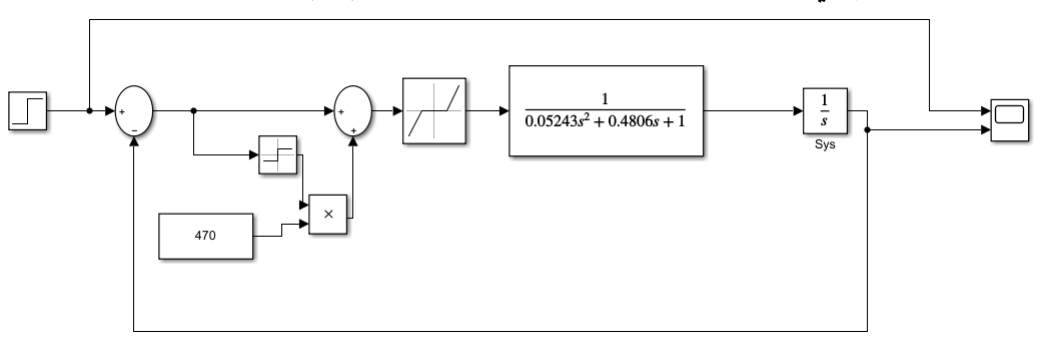
[picture p68: figure]

52

وكانت االستجابة وفق الشكل )44( :

شكل -44محاكاة استجابة النظام بوجود المنطقة الميتة
ُالحظ من الشكل السابق وجود خطأ حالة دائمة )

ي error state steady )ويتغيّر هذا الخطأ مع

تغيّر قيمة الجهد المطبّقة، وذلك بسبب وجود العنصر الالخطي )المنطقة الميّتة( وبالتالي نحتاج
تة، لذلك تَّم
ّ

إليجاد حل لالخطية المنطقة المي تطبيق المنهجية المعتمدة في األدبيات لحل الخطية تة
ّ

المنطقة المي وهي جمع أو طرح قيمة ثابتة )موافقة لمجال المنطقة الميتة( [1]. ّق

للتأكد من فعالية الحل المطب ، تم إضافة وطرح )حسب جهة الحركة( قيمة تة ّ

المنطقة المي إلى
إشارة دخل النظام في بيئة المحاكاة فكانت النتيجة وفق الشكل )45(:

شكل -45 نمذجة حل الخطية المنطقة الميتة

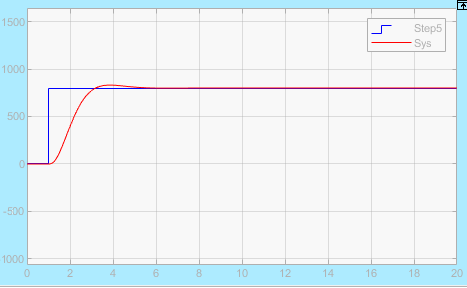
[picture p69: figure]
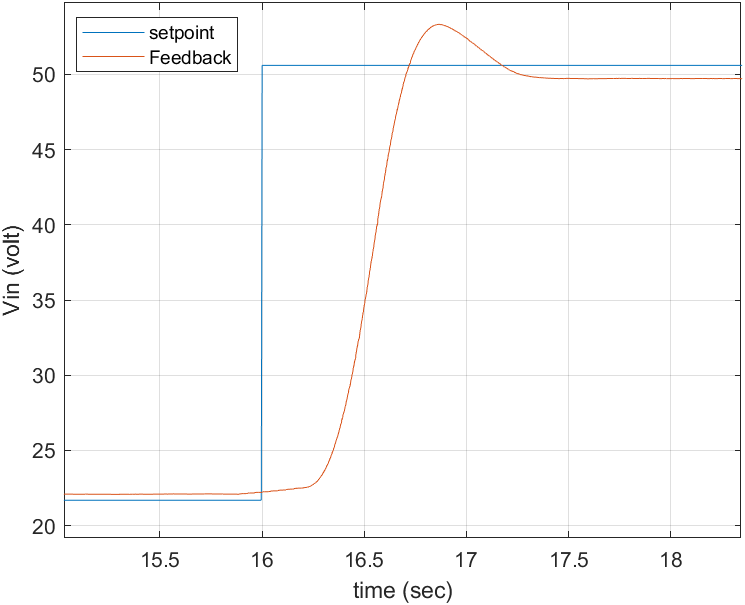
[picture p70: figure]

53

شكل -46 استجابة النظام بعد إدخال حل الخطية المنطقة الميتة
نالحظ أن شكل االستجابة مع إدخال الحل المقترح يوافق شكل االستجابة بدون وجود منطقة ميتة كما في الشكل )41(.
تة في الـمتحكم
ّ

الخطوة التالية هي زرع حل الخطية المنطقة المي ومشاهدة االستجابة الحقيقية، بعد إج ارء تجربة حقيقية ومشاهدة سلوك
ّ

تة في برنامج المتحكم تم
ّ

زرع حل الخطية المنطقة المي االستجابة وكانت قريبة من سلوك النظام في المحاكاة. يوضح الشكل )47( استجابة النظام الحقيقية بعد الترشيح:

شكل -47استجابة النظام الحقيقية بعد زرع حل الخطية المنطقة الميتة

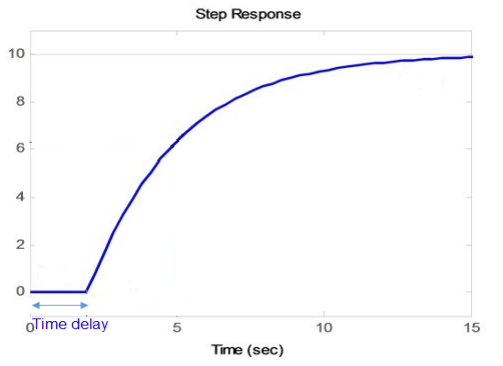
[picture p71: figure]

54

4.3.2 التأخير الزمني )delay Time): في النظام الهيدروليكي التأخير الزمني هو الفترة الزمنية الذي يحتاجه المكبس ليبدأ بالحركة بعد إرسال أمر الحركة، ويعتمد التأخير الزمني على الزمن الالزم لتدفق الزيت الهيدروليكي عبر المضخة إلى المخدم باإلضافة إلى ضغط التشغيل وزمن استجابة صمام التوجيه بشكل
ويعتمد أيضا لخشونة بين سطح المكبس واألسطوانة | ً | أساسي على مساحة سطح المكبس ومعامل ا
)االحتكاك( ولزوجة الزيت وأقطار أنابيب التوصيل [9].

شكل -48تعريف التأخير الزمني delay Time
وتَّم حساب التأخير الزمني بإجراء تجارب عديدة في نمط الدارة المفتوحة وحساب الفترة الزمنية ما بين إرسال أمر step وحركة المكبس، لوحظ من خالل التجارب أن زمن التأخير يتعلق بقيمة الجهد المطبق على صمام تخفيض الضغط التناسبي وهذه النتيجة منطقية النه كلما كان الجهد المطبق أكبر كلما كان الضغط على مخرج الصمام أكبر وبالتالي تدفق أكبر وهذا يعني سرعة استجابة أكبر وزمن تأخير أقل. سيتم استعراض نتائج التجارب لمالحظة تأثير جهد الدخل على زمن التأخير:

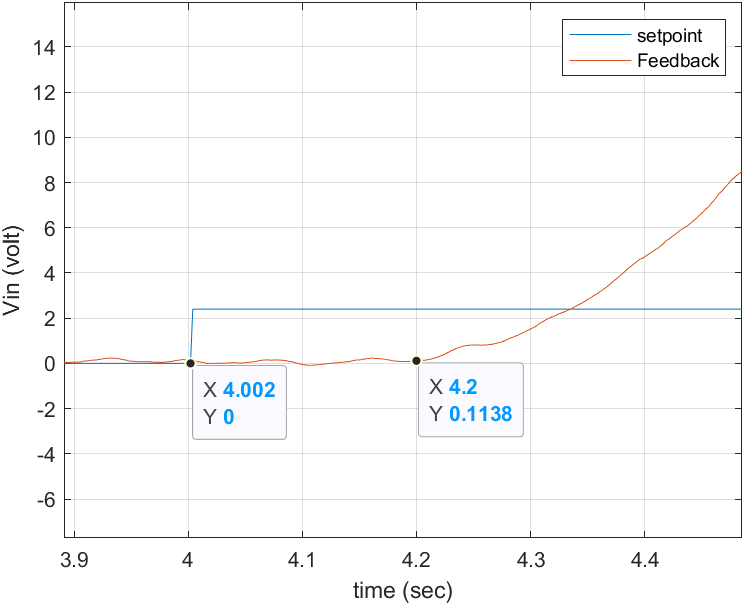
[picture p72: figure]

55

شكل -49 التأخيرالزمني من أجل دخل lov4 . = ets
يوضح الشكل السابق من أجل جهد دخل lov 2.4 أن زمن التأخير يساوي
.time Delay = 198ms
يلخص الجدول التالي النتائج التي تم الحصول عليها من التجارب:
Vin (volt) | Time Delay (ms)
2.4 | 198
3.6 | 118
6 | 112
10.8 | 104

جدول -4قيم التأخير الزمني من جهد دخل محدد
نالحظ تناقص التأخير الزمني بزيادة جهد الدخل. تم اعتماد قيمة تقريبية للتأخير الزمني m170 = aleD miT وهي قريبة من القيمة التي تم الحصول عليها في أثناء عملية التعرف وسيتم نمذجة التأخير الزمني في المحاكاة بدل تقريب باديه للحصول على استجابة أقرب ماتكون من استجابة النظام الحقيقية. تم نمذجة التأخير الزمني في الشكل )50(:

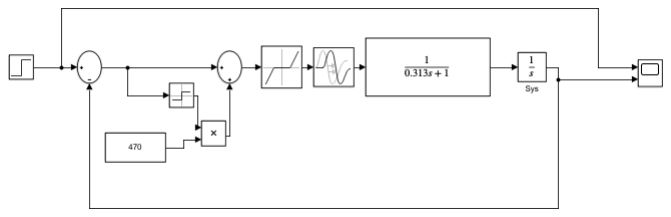
[picture p73: figure]
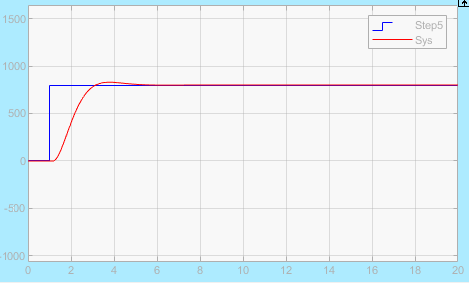
[picture p74: figure]

56

شكل -50نمذجة التأخير الزمني

شكل -51استجابة النظام بعد نمذجة التأخير الزمني
نالحظ من الشكل السابق ان شكل االستجابة قريب من استجابة النظام مع تقريب باديه في الشكل .)41(

4.3.3 حد اإلشباع (Saturation):

حد اإلشباع في دارة القيادة هو أعلى قيمة جهد يمكن تطبيقها على صمام تخفيض الضغط
volt 12 = sat . | التناسبي وبالتالي سيكون حد االشباع هو V

57

### 4.4 التحكم بالموضع:

يهدف التحكم بالموضع إلى تصميم متحكم يزيد من سرعة النظام في الحالة العابرة مع المحافظة على تجاوز أعظمي منخفض. لذا يعتبر المصحح المناسب لهكذا تصميم هو مقدم الطور Lead Phase الذي يستخدم بكثرة في مجال التحكم حيث يزيد من هامش الطور والذي بدوره يزيد من معامل التخامد النسبي و يزيد من عرض حزمة النظام B الذي يقابل تردد w. يوضح الجدول التالي المتطلبات التصميمية لنظام التحكم بالمخدم

عبور الربح
الكهروهيدروليكي:

المتطلب التصميمي الرمز القيمة

التجاوز األعظمي OS 4% ≤ OS

ts ≤ 2sec | ts

زمن االستجابة

خطأ الحالة الدائمة ess 0 = ess

شكل -52المتطلبات التصميمية لنظام التحكم بالمخدم الكهروهيدروليكي
يعطى شكل تابع النقل لمصحح مقدم الطور[17] بالشكل :
| G(s) = kp

Ts + 1
aTs + 1
م بتحديد موضع الصفر والقطب من خالل ّ

ُصم

وبالتالي فإ َّن هذا المصحح ي تحديد بارامترات تابع النقل للمصحح.
4.4.1 تحديد بارامترات المصحح: يتم تحديد بارامترات مصحح مقدم الطور باستخدام العالقات التالية [17]:

∅m = arcsin

a − 1
a + 1
حيث يتم اختيار قيمة ∅ وهي قيمة هامش الطور الذي سيقوم مقدم الطور بإضافته إلى النظام وبرسم مخطط بود للنظام نجد هامش الطور الحالي هو ed 60 = P ، ومن المتطلبات التصميمية السابقة نالحظ ان شرط التجاوز األعظمي هو 4 ≥ OS وحسب العالقة:

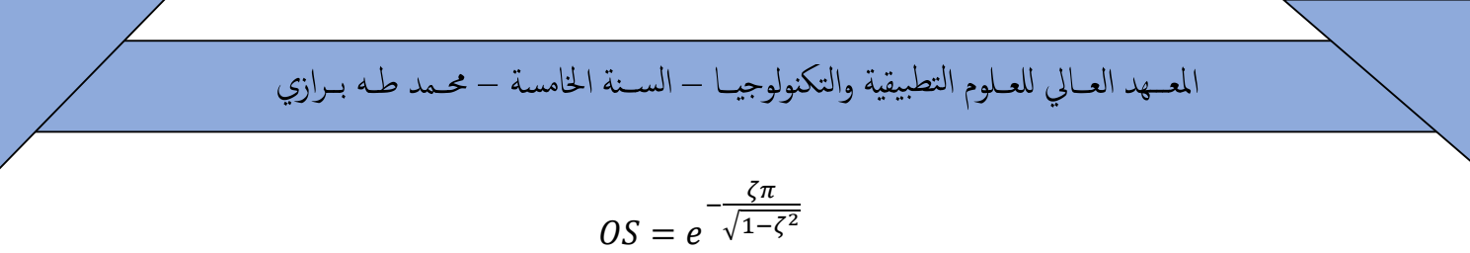
[picture p75: figure]

58

وهذا يقابل 0.7 ≤ ومن العالقة التقريبية يمكن إجاد هامش الطور المطلوب للنظام :

ξ ≈

PM(degree)
100°
و بالتالي نجد أنه يجب أن يكون ed 70 ≤ P ومن أجل تحقيق ذلك نفرض أن:
∅m | = 37 deg
→ a | ≅ 0.252
يتم تحويل قيمة إلى ديسبل بالعالقة التالية:

adB = −20 × log10

1
√a
→ adB | = −5.686 dB
| يتم استنتاج قيمة w من مخطط بو د للنظام في الحلقة المفتوحة الموافقة لـ da ومنها يتم استنتاج
قيمة وفق العالقة التالية:

wn =

1
T × √a
wn | = 6.997 rad/sec | → T ≅ 0.2847
سيتم اختيار قيمة 1.1 = k حيث يتم اختيارها بحيث تحقق خطأ حالة دائمة معدوم وبدون تجاوز أعظمي. بالتالي يصبح مصحح مقدم الطور على الشكل التالي:
| G(s) = 1.1

0.2847s + 1
0.07176s + 1
يوضح الشكل )53( مخطط بود للنظام مع وبدون مصحح مقدم الطور ويوضح الشكل مقدار الزيادة في هامش الطور نتيجة إضافة المصحح:

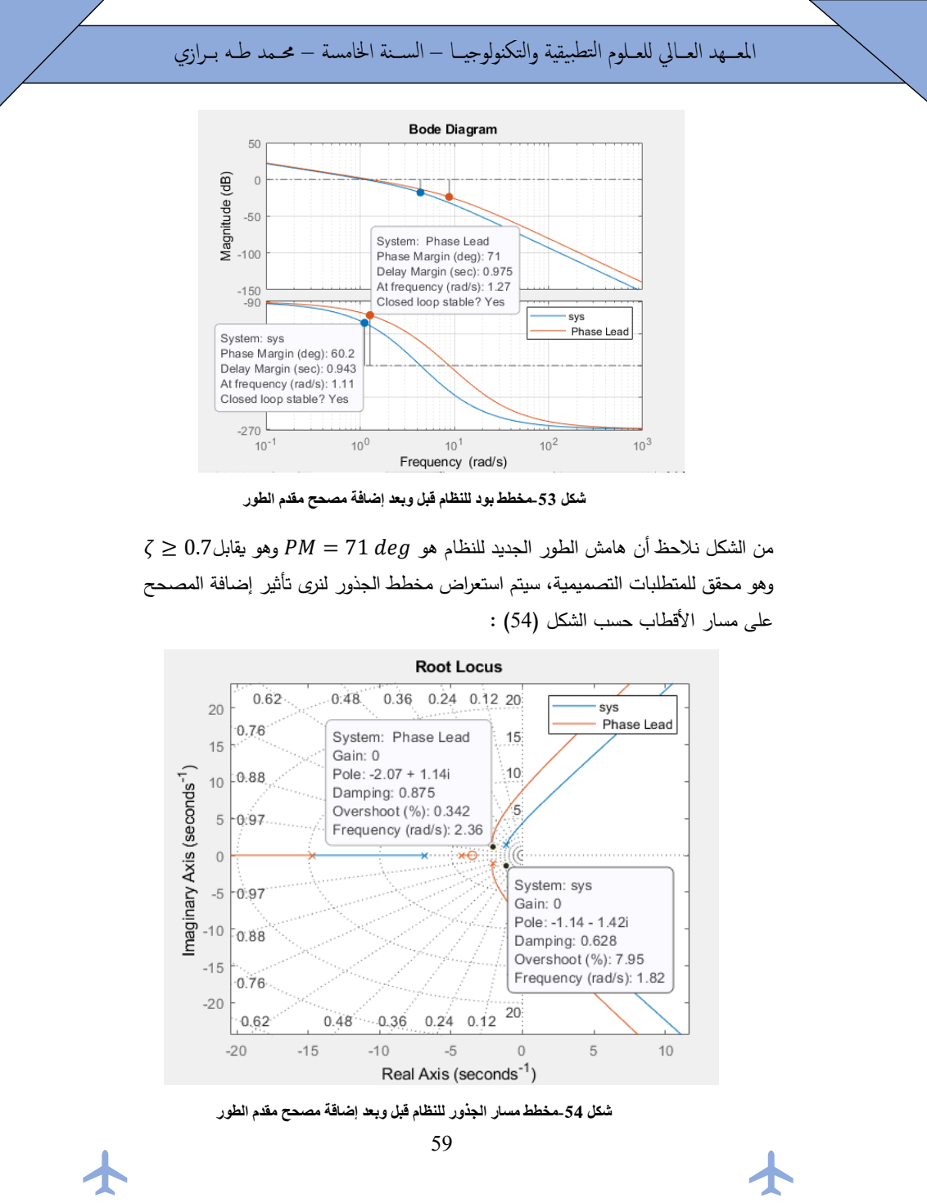
[picture p76: page 71]

59

شكل -53مخطط بود للنظام قبل وبعد إضافة مصحح مقدم الطور
من الشكل نالحظ أن هامش الطور الجديد للنظام هو ed 71 = P وهو يقابل0.7 ≤ وهو محقق للمتطلبات التصميمية، سيتم استع ارض مخطط الجذور لنرى تأثير إضافة المصحح على مسار األقطاب حسب الشكل )54( :

شكل -54مخطط مسار الجذور للنظام قبل وبعد إضاقة مصحح مقدم الطور


60

من مخطط السابق نالحظ كيف سببت إضافة المصحح إلى إضافة صفر وقطب نتج عنهم سحب مسار الجذور نحو يسار المستوي العقدي مما أدى إلى زيادة سرعة النظام، وكما نالحظ أن نسبة
، وبالتالي أصبح النظام أكثر استق ار ارً | التخميد أصبحت أكبر 0.875 = .
يجب عرض شكل االستجابة الزمنية لمعرفة الخصائص الزمنية للنظام. يوضح الشكل )55( استجابة النظام من أجل دخل قفزة :

شكل -55االستجابة الزمنية للنظام قبل وبعد إضافة مصحح مقدم الطور
es1.84 = وخطأ الحالة الدائمة 0 = se | من شكل االستجابة نالحظ أن زمن االستجابة
وهو محقق للمتطلبات التصميمة. وبذلك نجد أن جميع المتطلبات التصميمية محققة باستخدام المصحح المصمم. لذا سيتم تقطيع المصحح وزرعه في المتحكم لمراقبة شكل االستجابة الحقيقي.
ّ | 4.4.2 م الطور:

ة لمصحح مقد
ّ

المعادلة الفرقي
يتم استنتاج المعادلة الفرقية للمصحح للتمّكن من زرعه في برنامج األردوينو وذلك نة وزمن تقطيع معين.
ّ

باستخدام منهجية معي

61

4.4.2.1 اختيار زمن التقطيع: يتم اختيار زمن التقطيع بحيث يكون أكبر بكثير من عرض حزمة النظام. لذا تم اعتماد تردد تقطيع المصحح هو نفسه تردد حلقة التحكم في االردوينو:

fs = 500Hz
وبالتالي زمن التقطيع:

Ts =

1
fs

= 2msec
بعد اختيار زمن التقطيع يمكن تقطيع التابع التحويلي وفق منهجية “Tustin “باستخدام التعليمة التالية:

c2d(G, Ts

,

′ Tustin

′
)
ويصبح التابع التحويلي المتقطع للمصحح على الشكل التالي:

y[z]
X[z]

=

4.319 Z − 4.289
Z − 0.9725
ّ | وبالتالي تصبح ال ة على

معادلة الفرقي الشكل:

y[n] = 0.9725y[n − 1] + 4.319 [ X[n] − 0.933X[n − 1] ]
4.4.3 تجارب الدارة المغلقة مع مصحح مقدم الطور بعد عملية tuning: بعد زرع المعادلة الفرقية في المتحكم تم إجراء تجارب من أجل التحقق من أداء المصحح
وتم إجراء عملية توليف tuning على ربح المصحح بحيث نحصل على أفضل استجابة ممكنة وأصبحت المعادلة الفرقية للمصحح بعد التوليف هي :

y[n] = 0.9725y[n − 1] + 1.1(X[n] − 0.993 X[n − 1])
وكان شكل االستجابة كما هو موضح بالشكل)56( من أجل دخل mm30=Step:


62

شكل -56استجابة النظام الحقيقية قبل وبعد إضافة مصحح مقدم الطور
نالحظ من شكل االستجابة أنه ال يوجد تجاوز أعظمي 0 = O وزمن االستجابة
m230 = والثابت الزمني للنظام مع مصحح هو m90 ≅ وخطأ الحالة الدائمة |
.ً يوضح الجدول)5( مقارنة

0 = se وبذلك نجد أن جميع المتطلبات التصميمية محققة عمليا بين خصائص النظام قبل وبعد إضافة مصحح مقدم الطور ويظهر نسبة التحسين:
| | | خصائص النظام بدون مصحح مع مصحح PL نسبة التحسين
| | | التجاوز األعظمي O 8% اليوجد تجاوز 100%
| | | الثابت الزمني m220 m90 59%
| | | التأخير الزمني t m330 m130 60%
68% | 230ms | 730ms | زمن االستجابة ts
| | | خطأ الحالة الدائمة se 2% 0 = se 100%

جدول -5مقارنة بين خصائص النظام قبل وبعد إضافة مصحح مقدم الطور

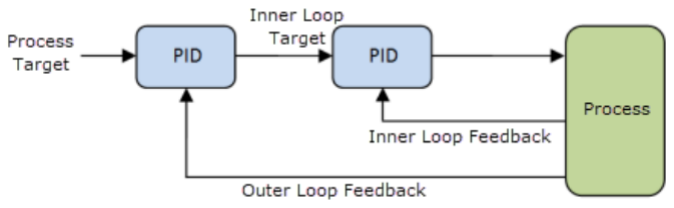
[picture p77: figure]

63

### 4.5 التحكم التتابعي Control Cascade:

التحكم التتابعي هو نوع من أنظمة التحكم التي تعتمد على سلسلة محددة من األوامر لتنفيذ
على ترتيب معين
ً

المهام بناء ويتم ذلك من خالل استخدام أكثر من حلقة تحكم متداخلة ببعضها البعض برمج النظام
ُ

. يتم استخدامه بشكل واسع في التحكم باآلالت واألجهزة الصناعية، حيث ي لالنتقال من مرحلة إلى أخرى عند تحقق شروط محددة. هذا النوع من التحكم مهم لضمان دقة العمليات وتجنب األخطاء التي قد تحدث في أنظمة التحكم اليدوية.

شكل -57التحكم التتابعي control Cascade
التتابعي في األنظمة البطيئة نسبيا بتحسين أداء النظام باستخدام حلقتي تحكم | ً | يستخدم التحكم ويقوم
ًة بالتحكم ذو الحلقة الواحدة

مقارن ، ويظهر ذلك بشكل جلي عندما يكون الخرج النهائي للنظام حساس للضجيج المرافق لحساس التغذية العكسية في حلقة التحكم المغلقة، وبالتالي سيؤثر ذلك على عملية التحكم أما في حالة وجود حلقتي تحكم فستقوم الحلقة الداخلية بتقليل أثر الضجيج وتصحيح أداء النظام بشكل مستمر. من أجل استخدام هذا النوع من التحكم يجب أن تكون الحلقة الداخلية أسرع بكثير وعلى األقل بثالث أضعاف من الحلقة الخارجية. من أهم الصعوبات التي تواجه تطبيق هذا النوع من التحكم هو الحاجة إلى حساسات قياس أخرى )قائس سرعة، قائس تسارع..إلخ(، باإلضافة إلى تصميم مصحح لكل حلقة يراد إضافتها إلى نظام التحكم وهذا ما يزيد من صعوبة عملية توليف المصححات حيث يجب البدء أوال من الحلقة الداخلية والتي تكون األسرع وصوالً إلى الحلقات الخارجية األبطأ.
باعتماد هذا المبدأ تم إ ضافة حلقة التسارع من أجل تحسين سرعة استجابة النظام.

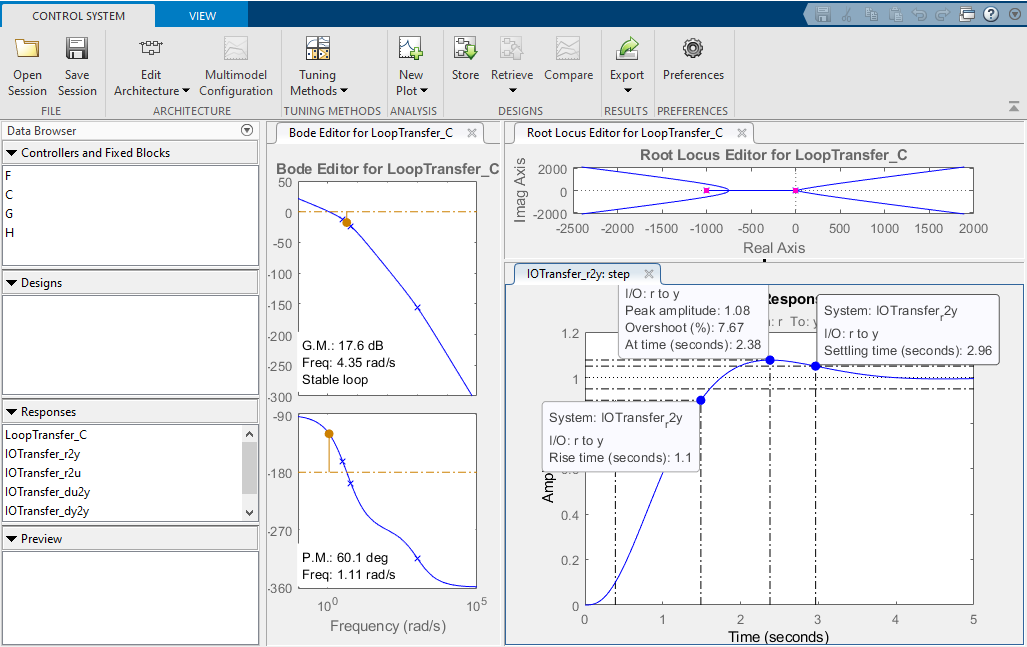
[picture p78: figure]

64

4.5.1 التحكم التتابعي باستخدام حلقة التسارع وحلقة الموضع: سيتم إضافة حلقة التسارع كحلقة داخلية، وستكون حلقة الموضع هي الحلقة الخارجية وستكون أبطأ بعشرة أضعاف من الحلقة الداخلية حيث سيكون تردد الحلقة الداخلية )حلقة التسارع( هو H500 بينما تردد الحلقة الخارجية )حلقة الموضع( H.50 سيتم تصميم مصحح للحلقة الداخلية والحلقة الخارجية باستخدام األداة التصميمية
( )engiseDmetsySlortnoc في ماتالب، وسيتم التصميم من الحلقة الداخلية.
ً

ابتداء
بعد االنتهاء من توليف الحلقة الداخلية يتم االنتقال إلى توليف الحلقة الخارجية بنفس الخطوات . نقوم باستدعاء نموذج Model Process المقدر من عملية التعرف بعد إجراء تقريب باديه على
التأخير الزمني باستخدام األداة التصميمية ( )engiseDmetsySlortnoc:

G(s) =

1
(1 + 0.313s)(1 + 0.167s)
controlSystemDesigner( G)
ستظهر النافذة التالية التي توضح استجابة النظام من أجل دخل قفزة وكذلك الخصائص الزمني للنظام:

شكل -58استجابة النظام في أداة engiseDmetsySlortnoc

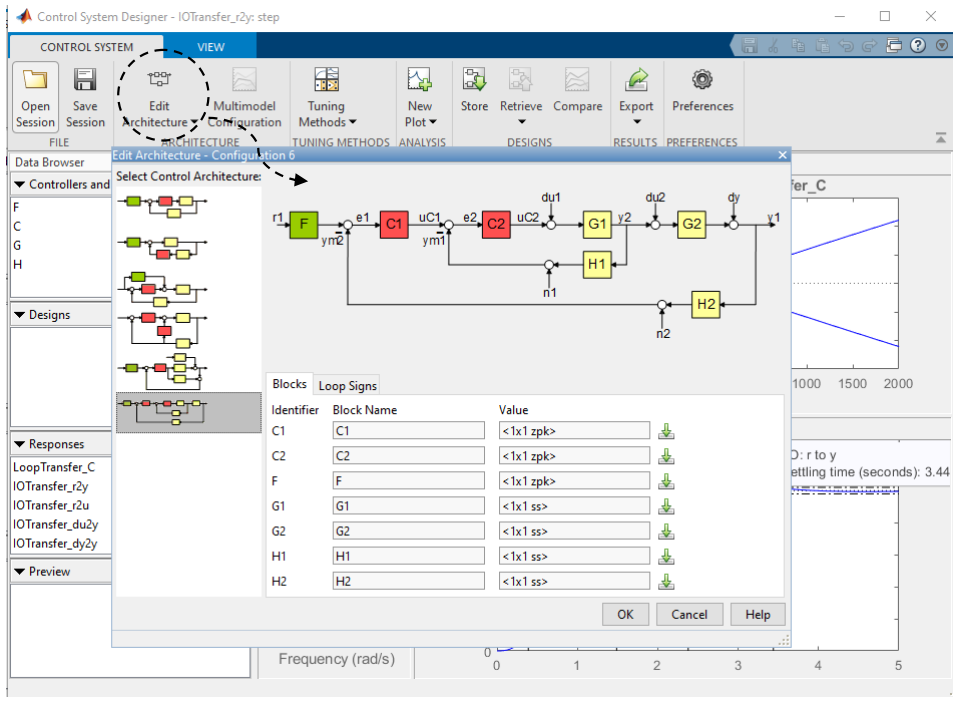
[picture p79: figure]

65

الهدف هو تصميم مصحح للحلقة الداخلية)حلقة التسارع( والحلقة الخارجية)حلقة الموضع( من أجل تحسين خصائص استجابة النظام الزمنية، لذا تم افتراض المتطلبات التصميمية وفق الجدول التالي :

المتطلب التصميمي الرمز القيمة

التجاوز األعظمي OS 10% ≤ OS

tr ≤ 500ms | tr | زمن الصعود
ts ≤ 2sec | | زمن االستجابة عند ess = 5% ts

شكل -59المتطلبات التصممية للنظام في حلقتي التحكم في التسارع والموضع
سيتم اختيار بنية نظام التحكم كحلقتي تحكم كما تتيح األداة وفق الشكل التالي:

شكل -60اختيار بنية حلقتي تحكم في أداة engiseDmetsySlortnoc

66

سيتم ترك جميع البلوكات السابقة بحتواها االفتراضي)1( وتعديل البلوكات الالزمة من خالل استيرادها من Workspace في ماتالب بعد تعريفها. ستيم االستيراد على الشكل التالي:

G1 = G(s)

G2 =

1
s

H1 =

s
s + 1
يعتبر خرج النظام 2 هو خرج سرعة لذا تم إضافة التابع 1 و هو مفاضل مع مرشح تمرير منخفض من أجل تخفض الضجيج الناتج عن عملية االشتقاق و تم إضافته في الحلقة الداخلية للتغذية العكسية للحلقة الداخلية من أجل تحصيل إشارة التسارع. وتم إضافة المكامل 2 من أجل تحصيل إشارة الموضع.
واالن سيتم إضافة مصحح للحلقة الداخلية PID مع مرشح من المرتبة األولى ومصحح للحلقة الخارجية PD مع مرشح من المرتبة االولى. يقدم ماتالب أداة الختيار أرباح المصحح IP بشكل أمثلي مايجعل إجرائية المحاولة والخطأ غير ضرورية. يمكن الدخول إلى خوارزمية التوليف بشكل
مباشر باستخدام األداة التفاعلية engiseD etsyS ortnoC.
سنستعمل Designer System Control من أجل الضبط األوتوماتيكي للمصححات من أجل استخدام هذه الطريقة، نذهب إلى الالئحة Methods Tuning لشريط System Control
.Automated Tuning | الئحة | تحت PID Tuning | ونختار .MATLAB في Designer
هناك خيارين يمكن اختيارها من الئحة المنسدلة method Tuning، هما response Robust
تولف Robust response time | خوارزمية | إن .Classical design formulas او time
بشكل أوتوماتيكي معامالت المصحح PID من أجل الموازنة بين سرعة االستجابة والصالبة. يمكنها توليف كل المعامالت ألي نمط من المصحح PID ويمكن استخدامها ألجل نظام مستقر أو غير مستقر، أو تكاملي. بينما خوارزمية formula design Classical تتطلب نظام مستقر أو تكاملي وال يمكنها توليف مرشح تفاضلي. إذا اخترنا formula design Classical، عندها في الئحة Formula يمكن مشاهدة عدد من الخيارات. هذه الخيارات تبدأ من تقنيات ارشادية مثل Nichols-Ziegler، إلى التقنيات العددية التي تبحث على كل أرباح التحكم الممكنة من أجل تقليل أدلة األداة المحددة. من أجل الحالة المدروسة، نختار خوارزمية time response Robust.

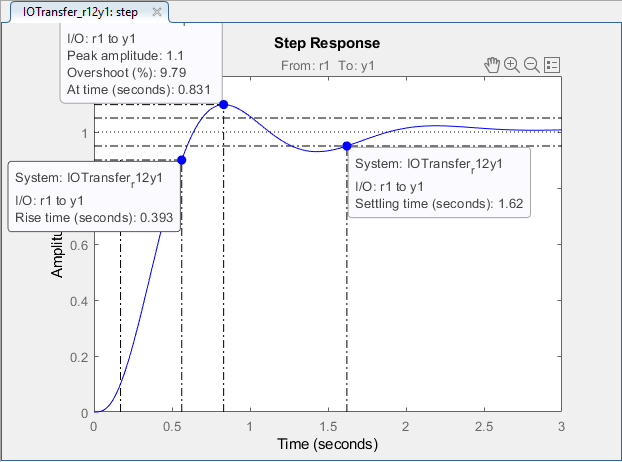
[picture p80: figure]

67

عندها في الئحة mode Design، يمكن اختيار Time أو Frequency. بما أن متطلبات النظام قيد االهتمام تم التعبير عنها في الوسط الزمني، نختار mode Design كـTime. بعدما يتم ضبط كل إعدادات التوليف، يتم النقر على زر Compensator Update ثم تبدء عملية التوليف بشكل أنعم حتى الحصول على االستجابة المطلوبة. يظهر الشكل التالي استجابة النظام بعد تصميم مصحح الحلقة الداخلية والخارجية:

شكل -61استجابة النظام بعد إضافة حلقتي تحكم
يو ضح الشكل التالي معامالت مصحح الحلقة الداخلية PID مع مرشح :

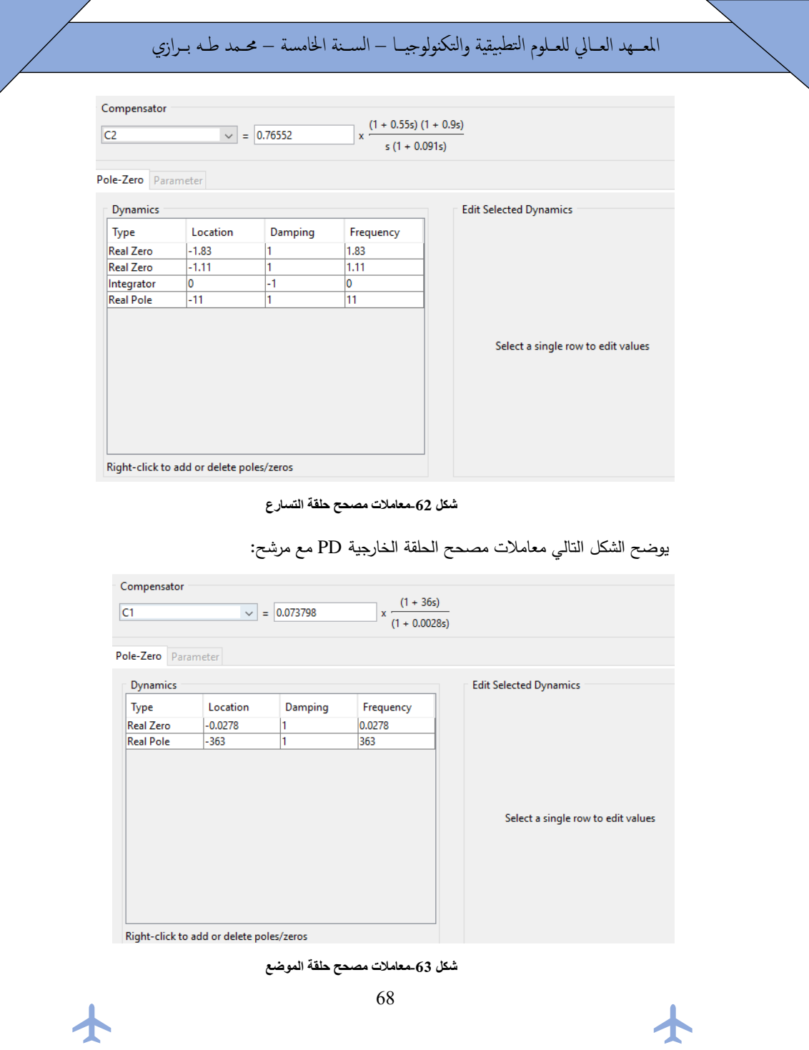
[picture p81: page 80]

68

شكل -62معامالت مصحح حلقة التسارع
يوضح الشكل التالي معامالت مصحح الحلقة الخارجية PD مع مرشح:

شكل -63معامالت مصحح حلقة الموضع

69

نالحظ من شكل االستجابة الموضح في الشكل )61( أن التصميم يحقق المتطلبات التصميمية المفترضة لذا يعتبر التصميم مقبول. 4.5.1.1 التنفيذ العملي لحلقة التسارع والوضع: تم استخدام حساس تسارع من نوع Piezoelectric من أجل قياس التسارع، ولكن اتضح أن الحساس ال يقوم بقياس التسارع الستاتيكي والذي يعتبر القيمة المفيدة في التحكم بالتسارع وإنما يقيس التسارع الديناميكي، أي التغير في التسارع وبالتالي يعتبر غير مفيد في مسألة التحكم في التسارع، وبسبب عدم توفر حساس تسارع مناسب من نوع MEMS إال في األيام األخيرة من عمل المشروع، لم يتيح الوقت فرصة لتنفيذ حلقتي التحكم بالتسارع والموضع التي يمكن تنفيذها في
ً | أعمال أخرى وفق المنجهية المشروحة .
سابقا

70

# الخاتمة و التوصيات المستقبلية:

في هذا العمل تم بناء وتطوير دارة قيادة موثوقة تلبي متطلبات التشغيل والتحكم بالمنظومة الكهروهيدروليكية، من ثم تطبيق إجرائية التعرف على النظام وتحصيل نماذج معامالتية خطية وغير خطية تستخدم في تطبيقات التحكم و التنبؤ، ب النهاية تم اعتماد نموذج العملية في تصميم مصحح للتحكم بالموضع مع تغذية أمامية، تم بعدها تصميم نظام تحكم تتابعي للتحكم بالتسارع و الموضع. في الختمام تم تصميم واجهة تخاطبية في بيئة ماتالب تسهل آلية القيادة والتحكم بالمخدم.
ته وهي:
ّ

وال بَّد من تقديم االقت ارحات والتوصيات التي تغني العمل وتزيد من أهمي
- استكمال البحث في موضوع التعرف على نظام المخدم من أجل تحصيل نماذج معامالتية الخطية تحاكي سلوك النظام الحقيقي في كامل مجال العمل.
- استكمال موضوع التحكم بالتسارع في إطار تحقيق بروفيل تسارع مطلوب باستخدام حساسات قياس مناسبة.
- استثمار إمكانية قياس التيار بإضافته كحلقة داخلية إلى نظام التحكم التتابعي.

71

# المراجع العلمية

ّ | .1 اجة مقادة

محمد الصالح و إيمان السروجي ،"تصميم وتنفيذ منصة قيادة واختبار لطاولة رج بمخدم هيدروليكي"،المعهد العالي للعلوم التطبيقية والتكنو لوجيا، حلب ، .2022

2. Arduino DUE https://store.arduino.cc/usa/due
3. SAM3X Atmel-ATARM-SAM3XA-Datasheet_23-Mar-15 .
4. Lennart Ljung, ‘System Identification : Theory for the user, Prentice Hall, Engelwood Cliffs, New Jerssy, 2nd edition 1989 .
5. LIU Bo, ZHAO Jun, and QIAN Jixin “Design and Analysis of Test Signals for System Identification”, V.N. Alexandrov et al. (Eds.): ICCS 2006, Part III, LNCS 3993, pp. 593 – 600, 2006. © Springer-Verlag Berlin Heidelberg 2006
6. MATLAB, (R2020a) and Simulink (Ver. 8.9), the MathWorks, Inc,
7. Abdul Ghani Al-Bakkar, “Real Time Temperature Control of a Test Rig” MSC dissertation, Control Engineering, University of Bradford,
U. K., 1993
8. JOHN F. GORMLEY, “TIME-DELAY OF VARIOUS TYPES OF HYDRAULIC REVERSING SYSTEMS”, Oklahoma State University, 1958
.9 د. عبد الغني البكار، "أساسيات في معالجة اإلشارة"، المعهد العالي للعلوم التطبيقية التكنولوجيا، 1.1 .Ver، حلب .2024 .10 د. عبد الغي البكار "التحكم الحديث - التحكم الرقمي"، المعهد العالي للعلوم التطبيقية والتكنولوجيا، 2.0 .Ver، حلب .2024 .11محمود حداد "تقدير النموذج التجريبي لمحرك تيار مستمر" مشروع السنة الرابعة في هندسة الطيران المعهد العالي للعلوم التطبيقية والتكنولوجيا، حلب .2022 .12محمود حداد "التعرف التجريبي والتحكم بنظام مخدم كهروهوائي"، مشروع السنة الخامسة في هندسة الطيران المعهد العالي للعلوم التطبيقية والتكنولوجيا، حلب .2022
13. David Vaseliou and Luis Cordova, “Using Motor Drivers to Drive Solenoid”, Application Note, Texas Instruments Incorporated .

72

14. TI Designs: TIDA-01506 –December 2017, “Reference Design for Automotive, Proportional-Solenoid Current Sensor”, Texas Instruments .Incorporated
15. BTS 7960, “High Current PN Half Bridge Data Sheet”, Rev. 1.1, December 2004 ’
16. Atos, the Italian electrohydraulic,” Reduced Proportional Valve type RZGO-TERS”, -AERS 3Way
17. Gene F. Franklin, “Digital Control of Dynamic systems”
